baobuibk/NANORACK_EXP_V101_HW/MEETING NOTE.docx

MEETING NOTE

OBC

Board OBC thêm chức năng OTA qua USB hoặc storage, update firmware cho chính OBC và những bo khác

USB5533 (USB3.0)

EXP

Sử dụng connector có chốt gài

Giảm bỏ effuse

Chủ động điều khiển laser, photo (OBC chỉ điều khiển EXP ko điều khiển laser, photo)

4 TEC

4 heater

2 i2c sensor

1 ir led

1 camera

1 usb

LASER

Thiếu test point

PHOTO

Photo diode đang sai chiều

Thiếu test point
