baobuibk/NANORACK_EXP_V101_HW/BOM/EXP_V101_BOM.xlsx

Name/Comment | Description | Designator | Footprint | Manufacturer | Manufacturer P/N | Quantity | STATUS | Order from | PLACE | Những thay đổi ngày 16/01/2025
BT_NRST | SWITCH TACTILE SPST-NO 0.05A 12V | BT1 |  | C&K | PTS636SK25FSMTRLFS | 1 | ORDERRED | EXP_V100
100uF 10V | CAP TANT 100UF 20% 10V 1206 | C1, C2, C6, C9, C18, C19, C20, C23 | TANTALUM_SMD_1206 | Kyocera AVX | TLJA107M010R1400 | 8 | ORDERRED | EXP_V100
4.7uF 25V | CAP CER 4.7UF 6.3V X7R 0603 | C3, C22, C70, C71, C72, C73, C96, C97, C98, C99, C153 | CN-SMD-0603 | Samsung | CL10B475KQ8NQNC | 11 | ORDERRED | EXP_V100 |  |  | ORDERRED | Đã mua trước đây
2.2nF 25V | CAP CER 2200PF 50V X7R 0603 | C4, C5, C7, C8 | CN-SMD-0603 | Samsung | CL10B222KB8NNNC | 4 | ORDERRED | EXP_V100 |  |  | NEW | Chưa mua trước đây
0.22uF 25V | CAP CER 0.22UF 25V X7R 0603 | C10, C11, C12, C13, C15, C16, C17, C21, C25, C32, C33, C34, C35, C36, C37, C38, C39, C40, C41, C42, C43, C44, C45, C46, C47, C48, C49, C50, C51, C52, C53, C54, C55, C56, C57, C58, C59, C60, C61, C62, C63, C64, C65, C66, C67, C68, C69, C76, C77, C78, C79, C92, C94, C102, C103, C104, C105, C118, C119, C122, C123, C124, C125, C126, C127, C128, C129, C130, C131, C132, C133, C134, C135, C140, C141, C144, C145, C147, C151, C152, C155, C156, C157, C158 | CN-SMD-0603 | Samsung | CL10B224KO8NNNC | 84 | ORDERRED | EXP_V100 |  | Thay đổi số lượng (87->84) | DNP | Do Not Place
0.01uF 25V | CAP CER 10000PF 50V X7R 0603 | C14 | CN-SMD-0603 | Samsung | CL10B103KB8NNNC | 1 | ORDERRED | PDU
0.1uF 25V | CAP CER 0.1UF 25V X7R 0603 | C24, C74, C75, C80, C81, C82, C83, C100, C101, C106, C107, C108, C109, C154 | CN-SMD-0603 | Samsung | CL10B104KA8NNNC | 14 | ORDERRED | EXP_V100
470nF 25V | CAP CER 0.47UF 16V X7R 0603 | C26 | CN-SMD-0603 | Samsung | CL10B474KO8NNNC | 1 | ORDERRED | EXP_V100
1uF 25V | CAP CER 1UF 25V X7R 0603 | C29, C30, C84, C85, C90, C91, C110, C111, C116, C117, C136, C137, C138, C139, C142, C143, C149, C150 | CN-SMD-0603 | Samsung | CL10B105KA8NNNC | 18 | ORDERRED | EXP_V100
47nF 25V | CAP CER 0.047UF 16V X7R 0603 | C86, C87, C88, C89, C93, C95, C112, C113, C114, C115, C120, C121 | CN-SMD-0603 | Samsung | CL10B473KO8NNNC | 12 | ORDERRED | EXP_V100
12pF 25V | CAP CER 12PF 50V C0G/NP0 0603 | C146, C148 | CN-SMD-0603 | TDK | C0603CH1E120K030BA | 2 | ORDERRED | EXP_V100
SS54 | DIODE SCHOTTKY 40V 5A SMA | D1, D2, D3 | DO214-AC-SMA | EVVO | SS54 | 3 | ORDERRED | EXP_V100
DSS14U | DIODE SCHOTTKY 40V 1A SOD123FL | D4 | SOD-123 | SMC | DSS14UTR | 1 | ORDERRED | EXP_V100
1N4148W-TP | DIODE GEN PURP 100V 300MA SOD123 | D6 | SOD-123 | MCC | 1N4148W-TP | 1 | ORDERRED | EXP_V100
YELLOW | LED YELLOW CLEAR 0603 SMD | DS1 | LED_0603_RED | Wurth Electronics | 150060YS75000 | 1 | ORDERRED | EXP_V100
RED | LED RED CLEAR 0603 SMD | DS2, DS3, DS4 | LED_0603_RED | Wurth Electronics | 150060RS75000 | 3 | ORDERRED | EXP_V100
GREEN | LED GREEN CLEAR 0603 SMD | DS5 | LED_0603_RED | Wurth Electronics | 150060GS75000 | 1 | ORDERRED | EXP_V100
BLUE | LED BLUE CLEAR 0603 SMD | DS6 | LED_0603_RED | Wurth Electronics | 150060BS75000 | 1 | ORDERRED | EXP_V100
JP5 | WR-PHD 2.54 mm Angled Socket Header | J1 |  |  |  | 1 |  |  | DNP
532610271 | CONN HEADER SMD R/A 2POS 1.25MM | J2 | 0532610271 | Molex | 0532610271 | 1 | NEW
~~532610871~~ | ~~CONN HEADER SMD R/A 8POS 1.25MM~~ |  | ~~0532610871~~ | ~~Molex~~ | ~~0532610871~~ | ~~1~~ | NEW |  |  | Không dùng trên V101 nữa
M80-6661642 | CONN HEADER SMD R/A 16POS 2MM | J3, J7 | m80-6661642 | Harwin | M80-6661642 | 2 | ORDERRED | EXP_V100 |  | Thay đổi số lượng (1->2)
M80-8283442 | CONN HEADER SMD 34POS 2MM | J4 | M80-8283442 | Harwin | M80-8283442 | 1 | ORDERRED | EXP_V100 |  | Thay đổi số lượng (2->1)
ESQ-107-48-G-D | CONN SOCKET 14POS 0.1 GOLD PCB | J5 | ESQ-107-48-G-D | Samtec | ESQ-107-48-G-D | 1 | NEW
532610971 | CONN HEADER SMD R/A 9POS 1.25MM | J6 | 532610971 | Molex | 0532610971 | 1 | NEW
BM04B-SRSS-TB | CONN HEADER SMD 4POS 1MM | J8, J9 | BM04B-SRSS-TB | JST | BM04B-SRSS-TBT(LF)(SN) | 2 | ORDERRED | EXP_V100
JP3 | WR-PHD 2.54 mm Angled Socket Header | J10 |  |  |  | 1 |  |  | DNP | Thay đổi từ "530470310" thành JP3 (2.54mm)
jumper2 |  | JP1, JP2 |  |  |  | 2 |  |  | DNP | Thêm component jumper, không linh kiện
22 μH | FIXED IND 22UH 2.5A 170 MOHM SMD | L1 | PSM6050 | Bourns | SRP7050TA-220M | 1 | ORDERRED | PDU
82uH | SRR4828A-820M | L2 | L-SMD-M-4.8x4.8x2.8mm | Bourns | SRR4828A-820M | 1 | ODERED | EXP_V100
1uH | FIXED IND 1UH 4A 38 MOHM SMD | L5, L6, L7, L8 | L-SMD-M-3.5x3.5x2mm | Bourns | SRP3020TA-1R0M | 4 | ODERED | EXP_V100
10uH/250mA | FIXED IND 10UH 300MA 600MOHM SMD | L9 | L-SMD-0603 | TDK | MLZ1608N100LT000 | 1 | ODERED | EXP_V100
AO3400A | MOSFET N-CH 30V 5.7A SOT23-3L | Q1, Q2, Q3, Q4 | SOT23-13_2 | Alpha & Omega Semiconductor | AO3400A | 4 | ODERED | EXP_V100
120R 1% | RES SMD 120 OHM 1% 1/10W 0603 | R1, R3, R59, R60, R95, R97, R99, R101 | RES-SMD-0603 | Panasonic | ERJ-3EKF1200V | 8 | ODERED | EXP_V100
10k 1% | RES SMD 10K OHM 1% 1/10W 0603 | R2, R4, R5, R6, R23, R24, R37, R41, R42, R45, R46, R51, R52, R79, R80, R81, R82, R89, R90, R91, R92, R96, R98, R100, R102, R109, R113, R122, R123, R124, R125, R126, R127, R128, R129, R132, R133 | RES-SMD-0603 | Panasonic | ERJ-3EKF1002V | 37 | ODERED | EXP_V100
470k 1% | RES SMD 470K OHM 1% 1/10W 0603 | R7, R9 | RES-SMD-0603 | Panasonic | ERJ-3EKF4703V | 2 | ODERED | EXP_V100
130k 1% | RES SMD 130K OHM 1% 1/10W 0603 | R8, R10 | RES-SMD-0603 | Panasonic | ERJ-3EKF1303V | 2 | ODERED | EXP_V100
3.24k 1% | RES SMD 3.24K OHM 1% 1/10W 0603 | R11 | RES-SMD-0603 | Panasonic | ERJ-3EKF3241V | 1 | ODERED | PDU
22R 1% | RES SMD 22 OHM 1% 1/10W 0603 | R12, R14, R15, R16, R17, R18, R19, R22, R25, R26, R27, R28, R32, R34, R35, R38, R39, R40, R49, R50, R55, R56, R62, R63, R66, R67, R69, R70, R72, R74, R75, R76, R77, R78, R83, R85, R86, R87, R88, R103, R104, R105, R106, R107, R114, R115, R116, R118, R119, R120, R121, R130, R131, R136, R137 | RES-SMD-0603 | Panasonic | ERJ-3EKF22R0V | 55 | ODERED | EXP_V100 |  | Thay đổi số lượng (58->55)
2k2 1% | RES SMD 2K2 OHM 1% 1/10W 0603 | R13, R29, R30, R31, R112, R117 | RES-SMD-0603 | Panasonic | ERJ-3EKF2201V | 6 | ODERED | EXP_V100
1k 1% | RES SMD 1K OHM 1% 1/10W 0603 | R20, R21, R33 | RES-SMD-0603 | Panasonic | ERJ-3EKF1001V | 3 | ODERED | EXP_V100
0R2 | RES SMD 0.2 OHM 1% 1W 1206 | R36 | RES-SMD-1206 | Yageo | PE1206FRF470R2L | 1 | ODERED | EXP_V100
100k 1% | RES SMD 100K OHM 1% 1/10W 0603 | R43, R44, R47, R48, R53, R54, R134, R135 | RES-SMD-0603 | Panasonic | ERJ-3EKF1003V | 8 | ODERED | EXP_V100
4.7k 1% | RES SMD 4.7K OHM 1% 1/10W 0603 | R57, R58, R61, R64, R65, R68, R71, R73, R84, R138 | RES-SMD-0603 | Panasonic | ERJ-3EKF4701V | 10 | ODERED | EXP_V100 |  | Thay đổi số lượng (8->10)
1k 1% / DNP | RES SMD 1K OHM 1% 1/10W 0603 | R108 | RES-SMD-0603 | Panasonic | ERJ-3EKF1001V | 1 | ODERED | EXP_V100 | DNP
16.5k1% | RES SMD 16K5 OHM 1% 1/10W 0603 | R110 | RES-SMD-0603 | Panasonic | ERJ-3EKF1652V | 1 | ODERED | EXP_V100
19.1k 1% | RES SMD 19K1 OHM 1% 1/10W 0603 | R111 | RES-SMD-0603 | Panasonic | ERJ-3EKF1912V | 1 | ODERED | EXP_V100
TVS2200DRVR | UNIDIR PRECISION SURGE DIODE | TVS1, TVS2 | TVS2200 | Texas Instruments | TVS2200DRVR | 2 | ODERED | EXP_V100
S2305 | TVS DIODE 5VWM 10.8VC SOT23 | TVS4, TVS8, TVS10, TVS15, TVS16 | sot23-12_3 | SMC Diode Solutions | S2305 | 5 | ODERED | EXP_V100 |  | Thay đổi số lượng (6->5)
TPS259470ARPWR | IC ELECTRONIC FUSE 10VQFN | U1, U2 | VQFN-HR-10 | Texas Instruments | TPS259470ARPWR | 2 | ODERED | EXP_V100
TPS5430DDAR | IC REG BUCK ADJ 3A 8SOPWR | U3 | TPS5430DDAR | Texas Instruments | TPS5430DDAR | 1 | ODERED | PDU
TPS7A4533DCQR | IC REG LINEAR 3.3V 1.5A SOT223-6 | U4 | SOT223_6 | Texas Instruments | TPS7A4533DCQR | 1 | ODERED | EXP_V100
AL8843SP-13 | IC LED DRIVER RGLTR PWM 3A 8SO | U5 | SO8_EPAD | Diodes | AL8843SP-13 | 1 | ODERED | EXP_V100
OPA2340UA | IC CMOS 2 CIRCUIT 8SOIC | U6, U7, U9, U10 | SO8 | Texas Instruments | OPA2340UA | 4 | ODERED | EXP_V100
ADG1414BCPZ-REEL7 | IC SW SPST-NOX8 11.5OHM 24LFCSP | U8 | ADG1414 | Analog Devices Inc. | ADG1414BCPZ-REEL7 | 1 | NEW |  |  | Thêm part mới cho V101
ADUM1250WSRZ | DGTL ISOL 2500VRMS 2CH I2C 8SOIC | U11 | SOIC-8 | Analog Devices | ADUM1250WSRZ | 1 | ODERED | EXP_V100
ISO1432DW | IC TRANSCEIVER FULL 1/1 16SOIC | U12 | ISO1432DW | Texas Instruments | ISO1432DW | 1 | ODERED | EXP_V100
ISO1042BQDWVRQ1 | IC TRANSCEIVER FULL 1/1 8SOIC | U13 | ISO1042 | Texas Instruments | ISO1042BQDWVRQ1 | 1 | ODERED | EXP_V100
LT8722AV#PBF | IC GATE DRVR FULL-BRIDGE 18QFN | U14, U15, U16, U17 | QFN18 | Analog Devices | LT8722AV#PBF | 4 | ODERED | EXP_V100
STM32F407VGT7 | ARM® Cortex®-M4 STM32F4 Microcontroller IC 32-Bit Single-Core 168MHz 1MB (1M x 8) FLASH 100-LQFP (14x14) | U18 | LQFP-100 | STMicroelectronics | STM32F407VGT7 | 1 | ODERED | EXP_V100
TPL5010DDCR | IC OSC PROG TIMER TSOT23-6 | U19 | SOT23-6-123_456 | Texas Instruments | TPL5010DDCR | 1 | ODERED | EXP_V100
PCA9508DP,118 | IC REDRIVER I2C HOTSWAP 8TSSOP | U20, U21 | TSOP8 | NXP Semiconductors | PCA9508DP,118 | 2 | ODERED | EXP_V100
8MHz | Crystal, 8 MHz, -30 to 85 degC, 3.2 x 2.5 x 0.9 mm SMD | X1 | XT4-16.000MHz-4_V | ECS International | ECS-80-8-33Q-ADS | 1 | ODERED | EXP_V100
510210200 | CONN RCPT HSG 2POS 1.25MM | Mating with J2 |  | Molex | 0510210200 | 1 | NEW |  | Wire for connector
~~510210800~~ | ~~CONN RCPT HSG 8POS 1.25MM~~ | ~~Mating with ~~ |  | ~~Molex~~ | ~~0510210800~~ | ~~1~~ | ~~NEW~~ |  | ~~Wire for connector~~ | Không dùng cho V101 nữa
M80-8881605 | CONN RCPT 8POS CRIMP 24-28AWG | Mating with J3, J7 |  | Harwin Inc. | M80-8880805 | 1 | ORDERRED | EXP_V100 | Wire for connector
M80-8883405 | CONN RCPT 34POS CRIMP 24-28AWG | Mating with J4 |  | Harwin Inc. | M80-8883405 | 1 | ORDERRED | EXP_V100 | Wire for connector
510210900 | CONN RCPT HSG 9POS 1.25MM | Mating with J6 |  | Molex | 0510210900 | 1 | NEW |  | Wire for connector
A04SR04SR30K152B | JUMPER 04SR-3S - 04SR-3S 6" | Mating with J8, J9 |  | JST Sales America Inc. | A04SR04SR30K152B | 2 | ORDERRED | EXP_V100 | Wire for connector
~~0510210300~~ | ~~CONN RCPT HSG 3POS 1.25MM~~ | ~~Mating with J10~~ |  | ~~Molex~~ | ~~0510210300~~ | ~~1~~ | ~~NEW~~ |  | ~~Wire for connector~~ | Không dùng cho V101 nữa
