baobuibk/NANORACK_EXP_V101_HW/SCHEMATIC/EXP_V101_SCHE.pdf

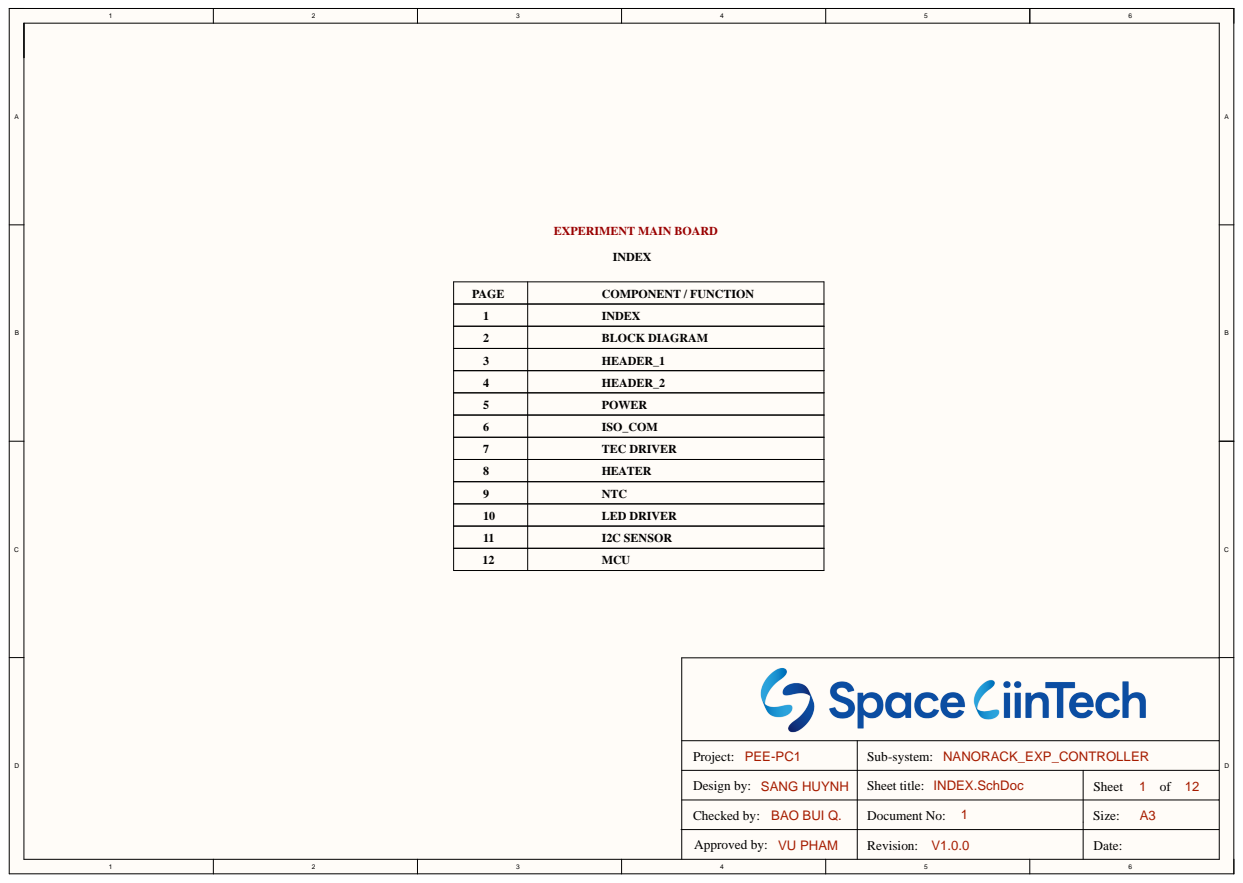
[picture p1: page 1]

PAGE | COMPONENT / FUNCTION

1 INDEX

2 | BLOCK DIAGRAM

3 | HEADER_1

4 | HEADER_2

5 | POWER

6 | ISO_COM

7 | TEC DRIVER

8 | HEATER

9 | NTC

10 | LED DRIVER

11 | I2C SENSOR

12 | MCU

Project: PEE-PC1 | Sub-system: NANORACK_EXP_CONTROLLER

Design by: SANG HUYNH | Sheet title: INDEX.SchDoc | Sheet 1 of 12

Checked by: BAO BUI Q. | Document No: 1 | Size: A3

Approved by: VU PHAM | Revision: V1.0.0 | Date:

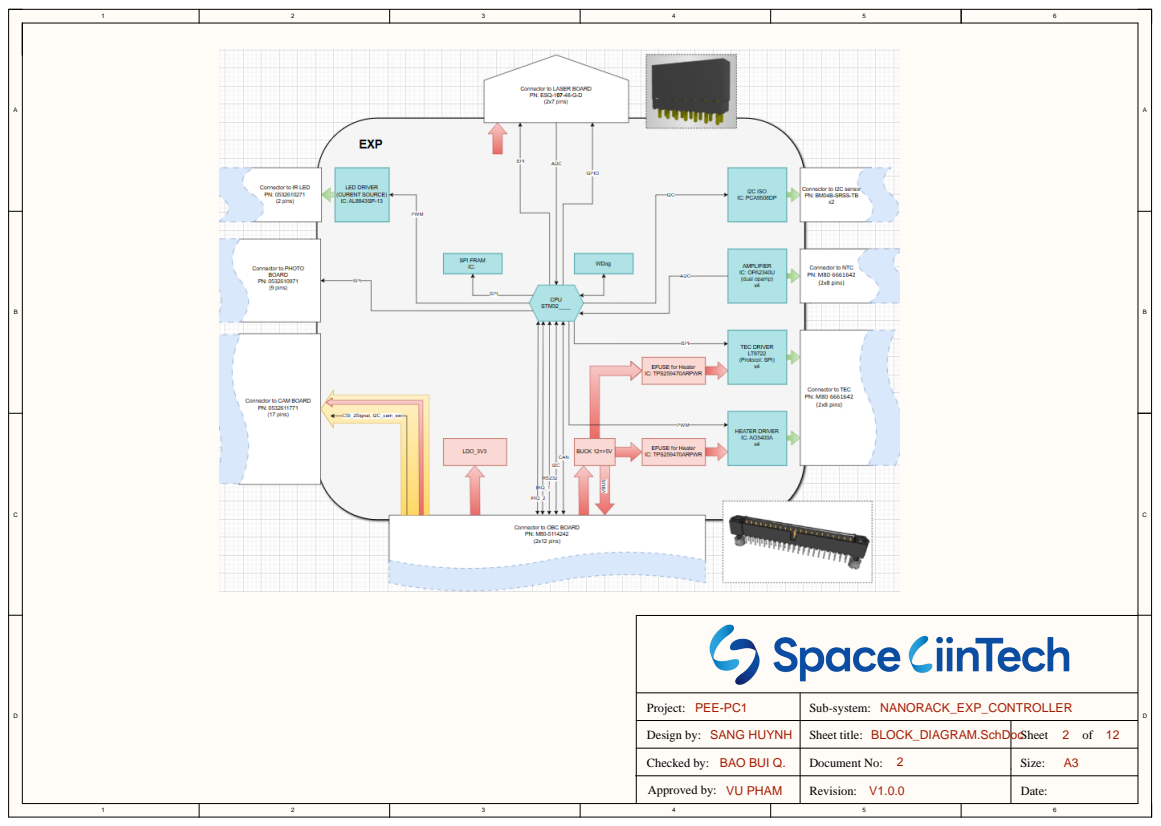
[picture p2: page 2]

Project: PEE-PC1 | Sub-system: NANORACK_EXP_CONTROLLER

Design by: SANG HUYNH | Sheet title: BLOCK_DIAGRAM.SchDoc | Sheet 2 of 12

Checked by: BAO BUI Q. | Document No: 2 | Size: A3

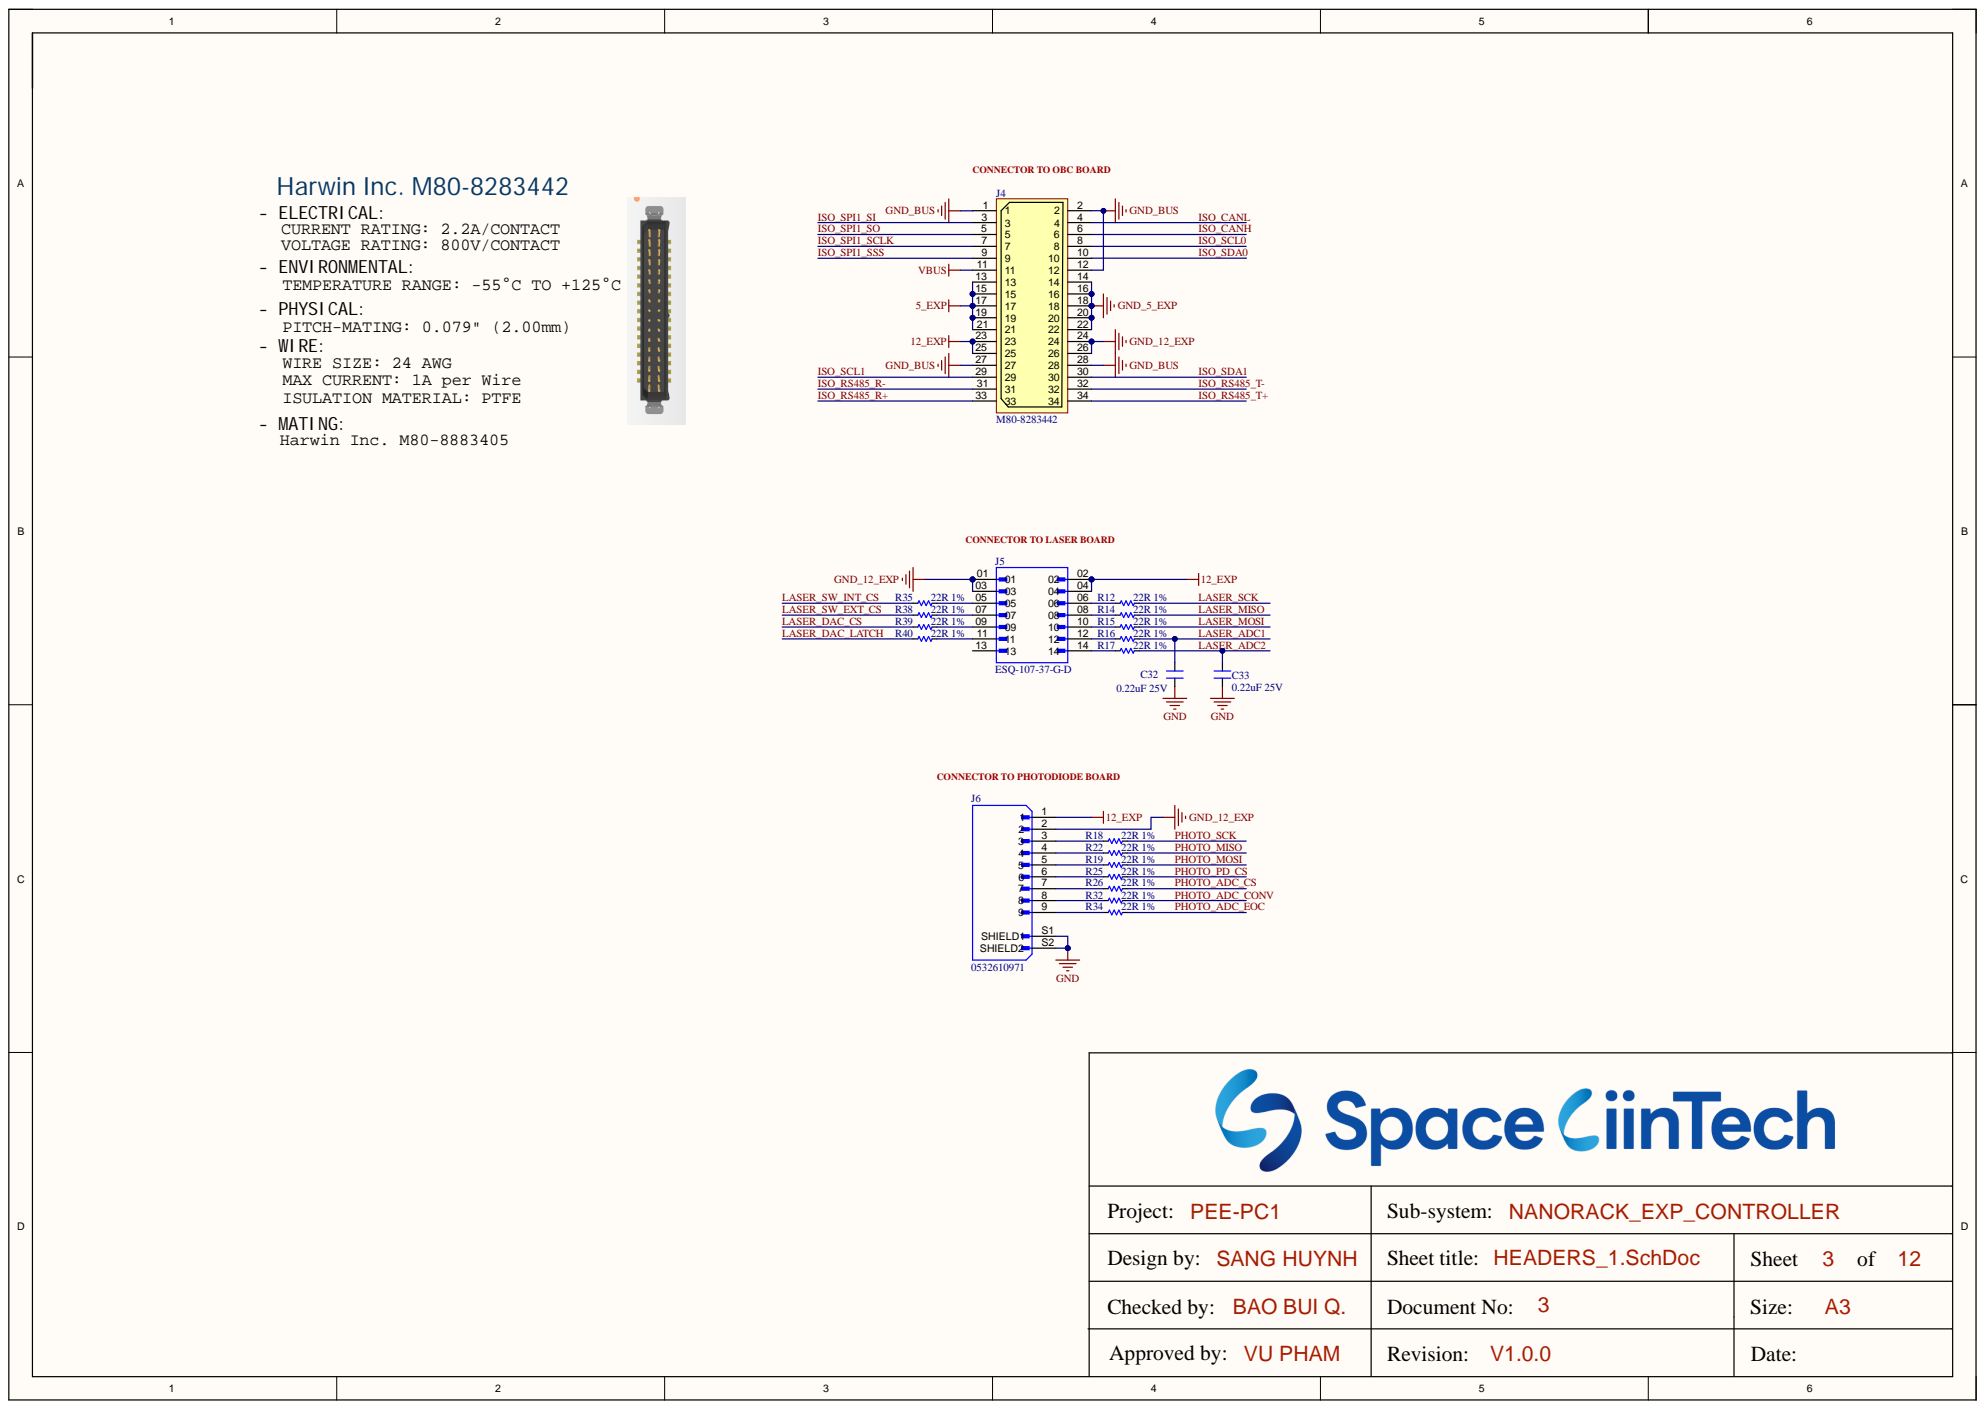
[picture p3: page 3]

CONNECTOR TO OBC BOARD

- ELECTRICAL: CURRENT RATING: 2.2A/CONTACT VOLTAGE RATING: 800V/CONTACT

- ENVIRONMENTAL: TEMPERATURE RANGE: -55°C TO +125°C

- WIRE:
WIRE SIZE: 24 AWG
MAX CURRENT: 1A per Wire
ISULATION MATERIAL: PTFE
- MATING: Harwin Inc. M80-8883405

CONNECTOR TO LASER BOARD

C | GND | C

CONNECTOR TO PHOTODIODE BOARD

Project: PEE-PC1 | Sub-system: NANORACK_EXP_CONTROLLER

Design by: SANG HUYNH | Sheet title: HEADERS_1.SchDoc | Sheet 3 of 12

Checked by: BAO BUI Q. | Document No: 3 | Size: A3

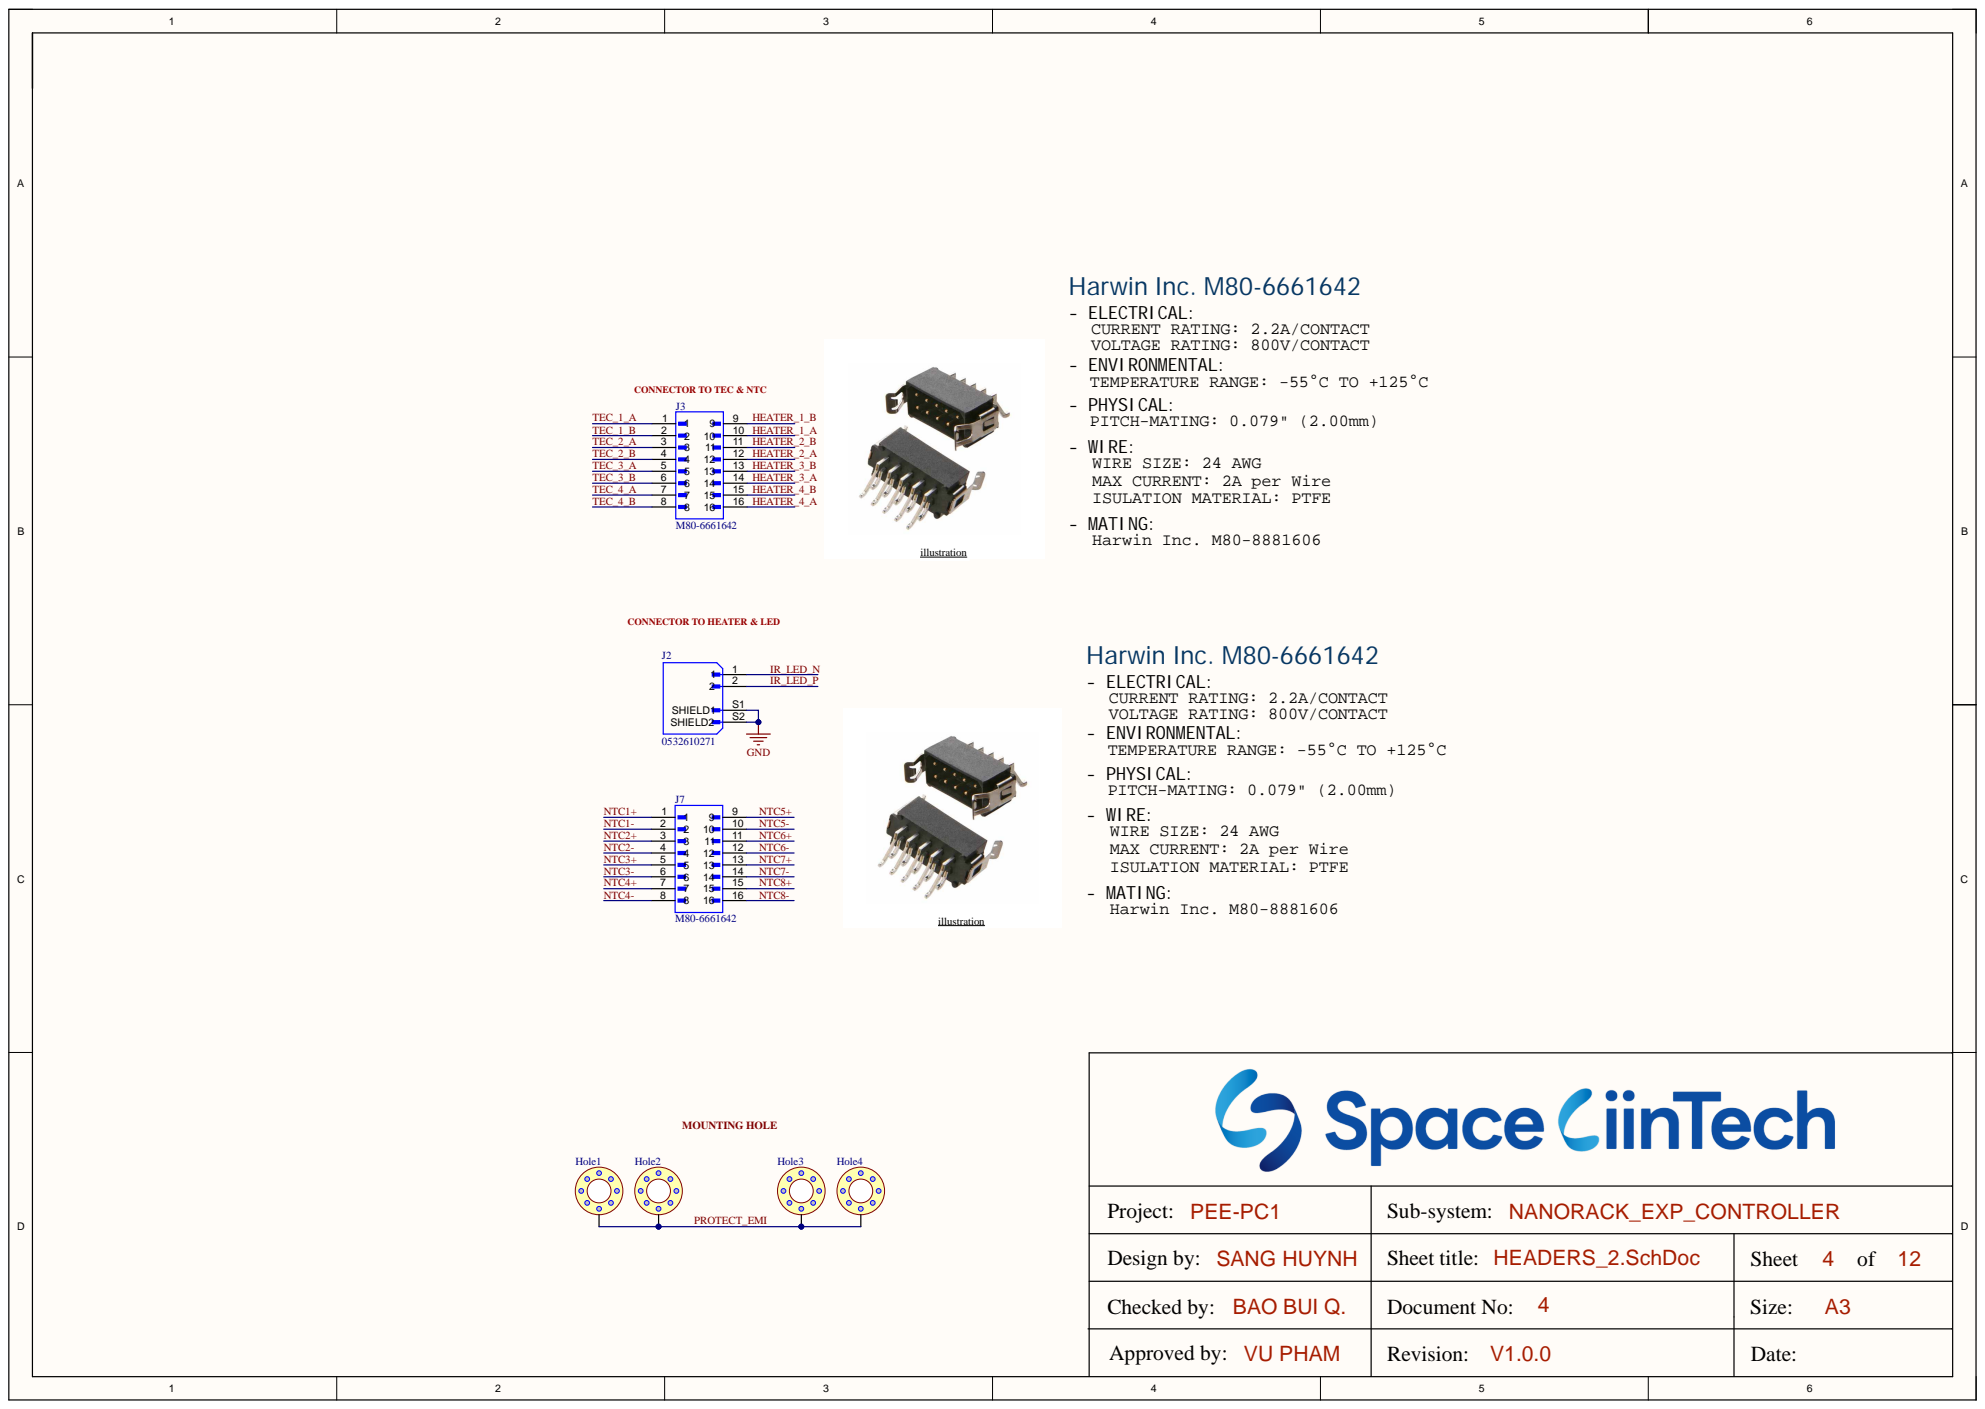
[picture p4: page 4]

- ELECTRICAL: CURRENT RATING: 2.2A/CONTACT VOLTAGE RATING: 800V/CONTACT

- ENVIRONMENTAL: TEMPERATURE RANGE: -55°C TO +125°C

CONNECTOR TO TEC & NTC

- WIRE:
WIRE SIZE: 24 AWG
MAX CURRENT: 2A per Wire
ISULATION MATERIAL: PTFE
- MATING:
Harwin Inc. M80-8881606

CONNECTOR TO HEATER & LED

Project: PEE-PC1 | Sub-system: NANORACK_EXP_CONTROLLER

Design by: SANG HUYNH | Sheet title: HEADERS_2.SchDoc | Sheet 4 of 12

Checked by: BAO BUI Q. | Document No: 4 | Size: A3

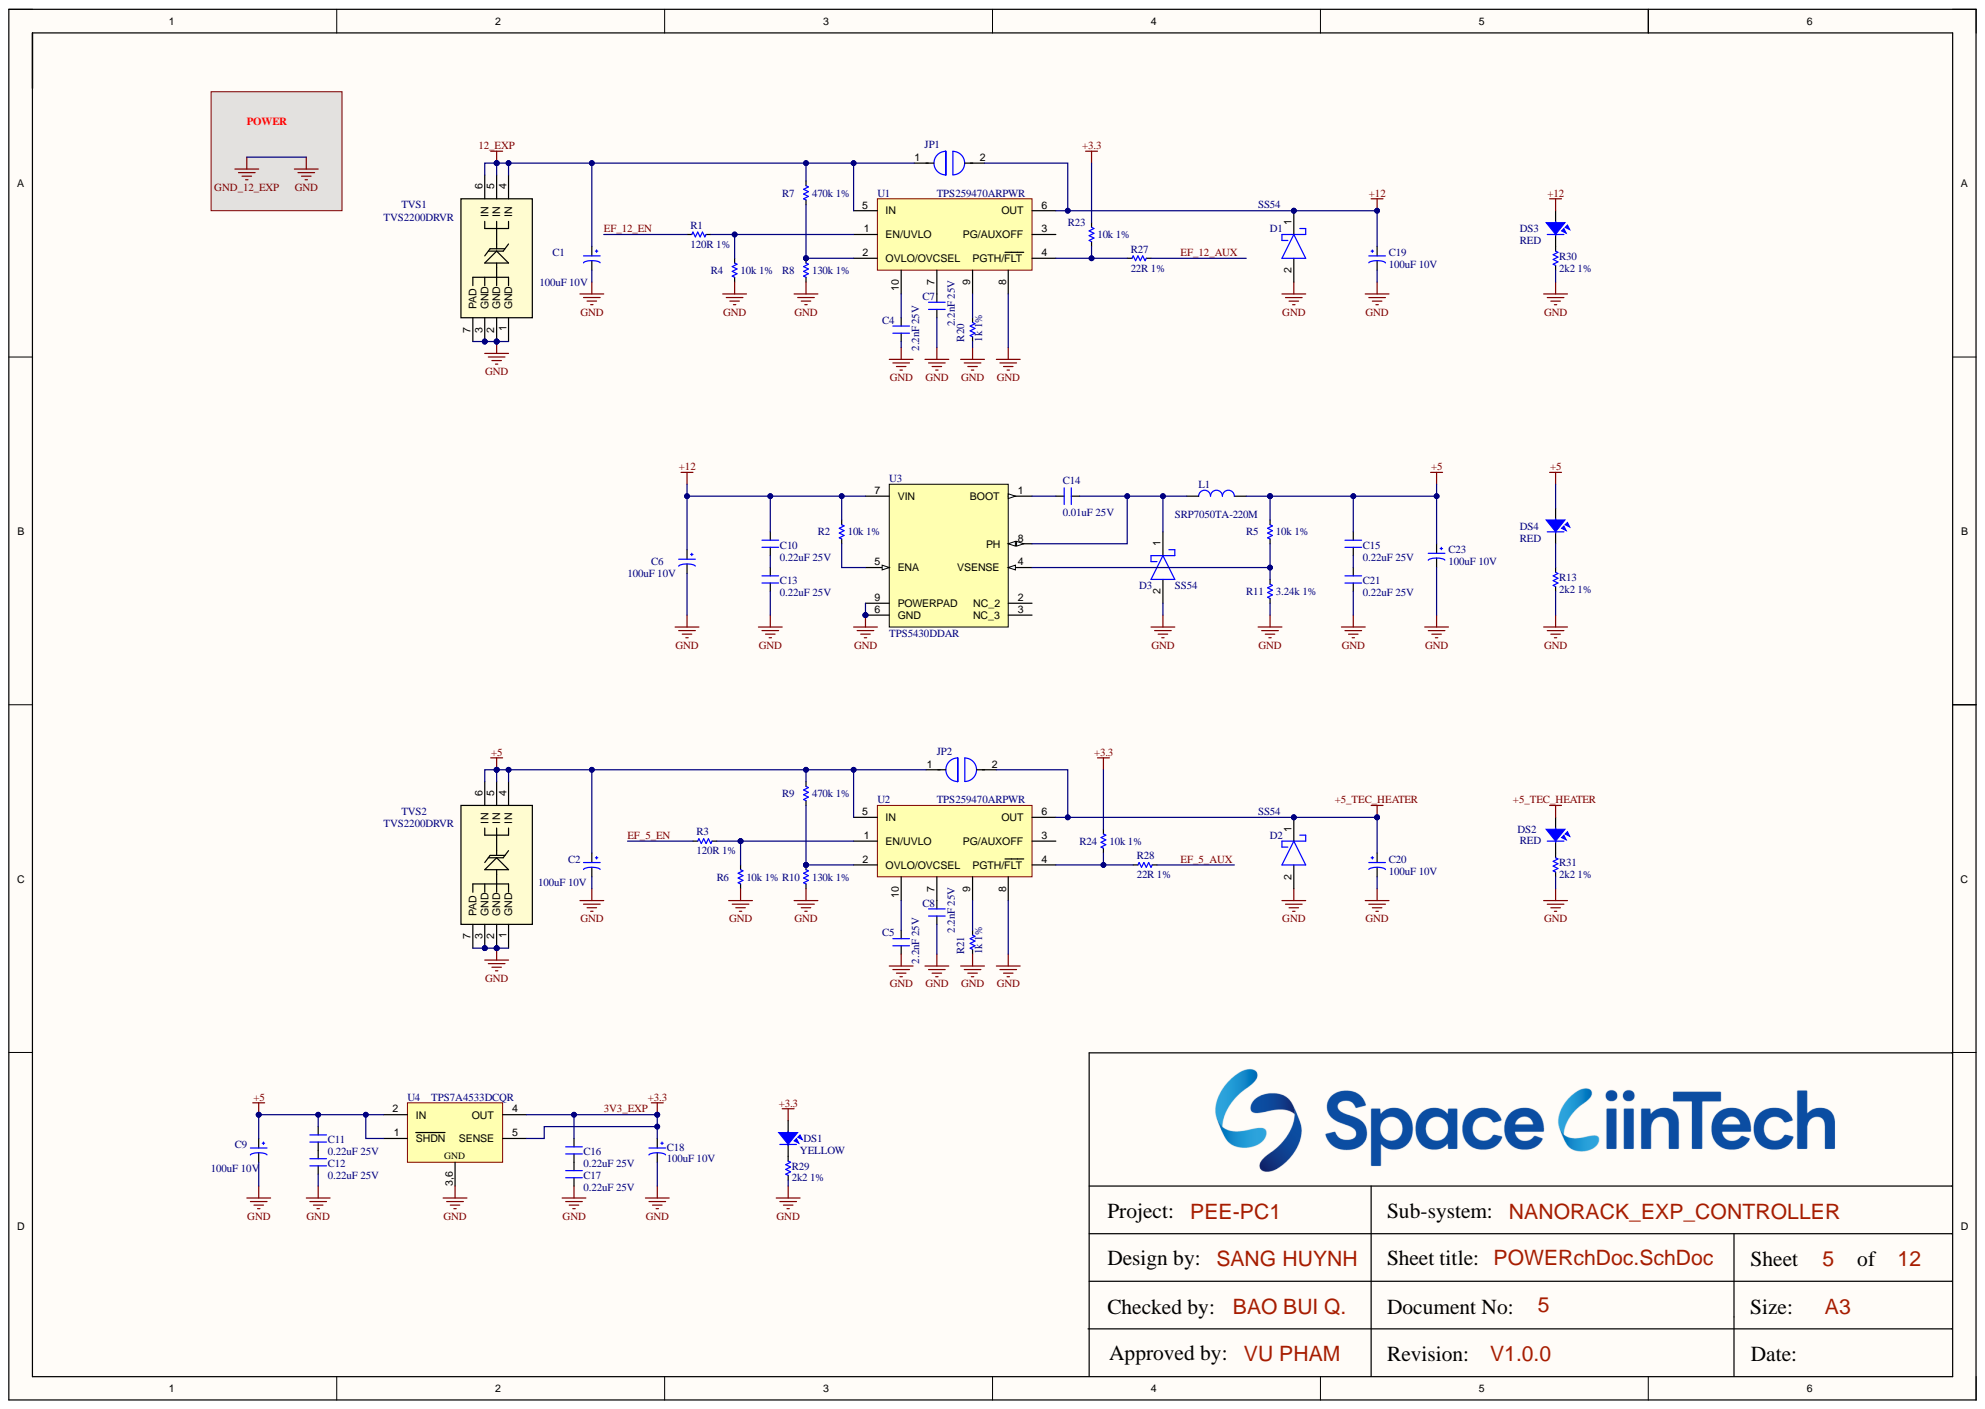
[picture p5: page 5]

IN 4 IN 5 IN 6 PAD 7

Project: PEE-PC1 | Sub-system: NANORACK_EXP_CONTROLLER

Design by: SANG HUYNH | Sheet title: POWERchDoc.SchDoc | Sheet 5 of 12

Checked by: BAO BUI Q. | Document No: 5 | Size: A3

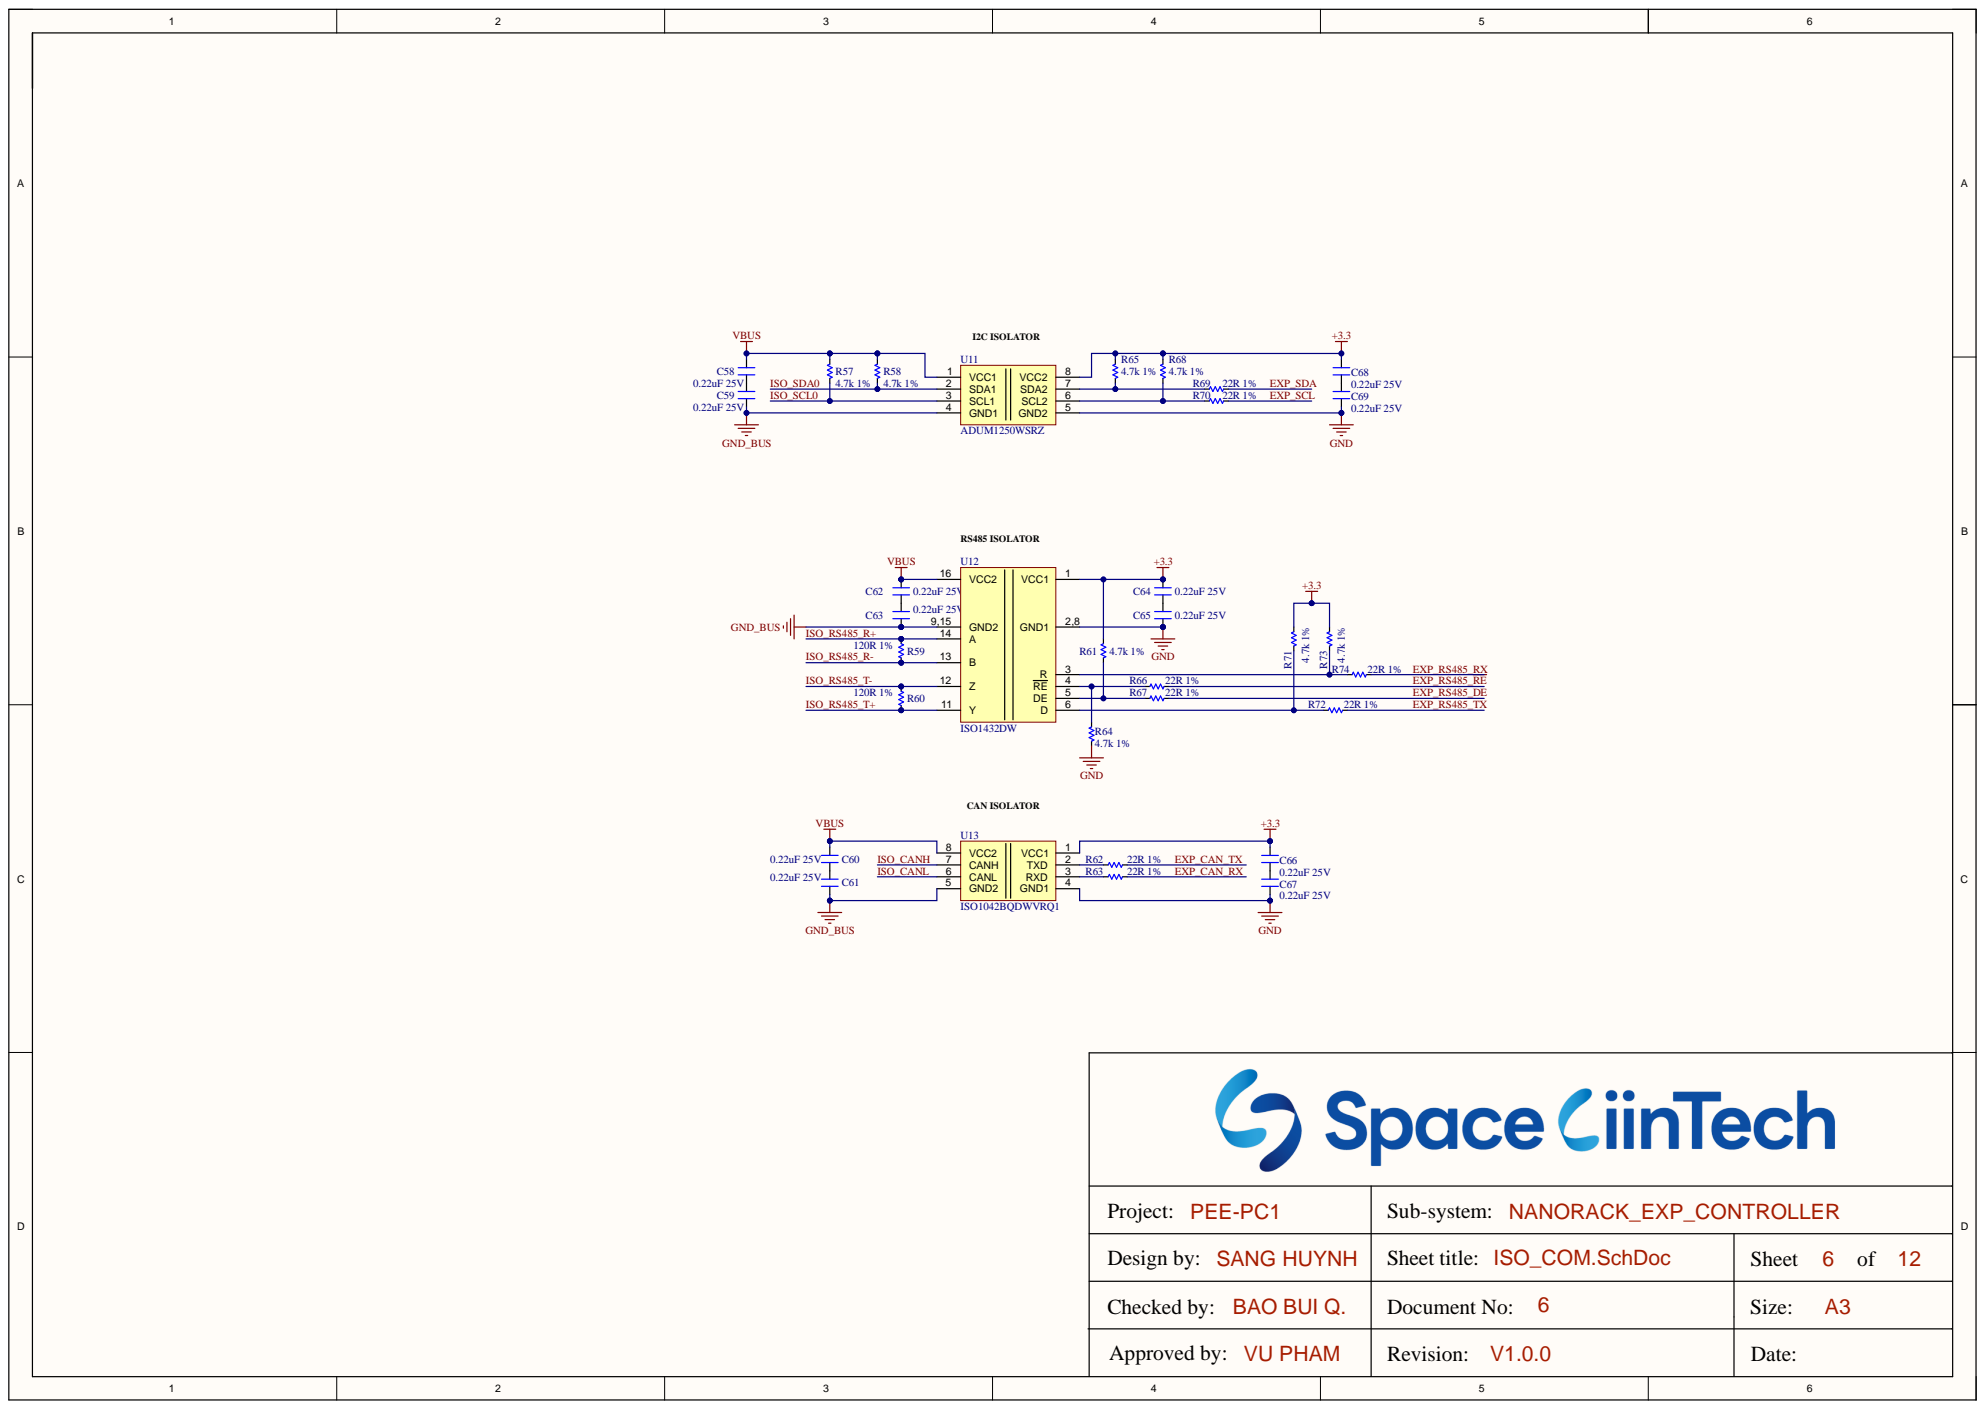
[picture p6: page 6]

Project: PEE-PC1 | Sub-system: NANORACK_EXP_CONTROLLER

Design by: SANG HUYNH | Sheet title: ISO_COM.SchDoc | Sheet 6 of 12

Checked by: BAO BUI Q. | Document No: 6 | Size: A3

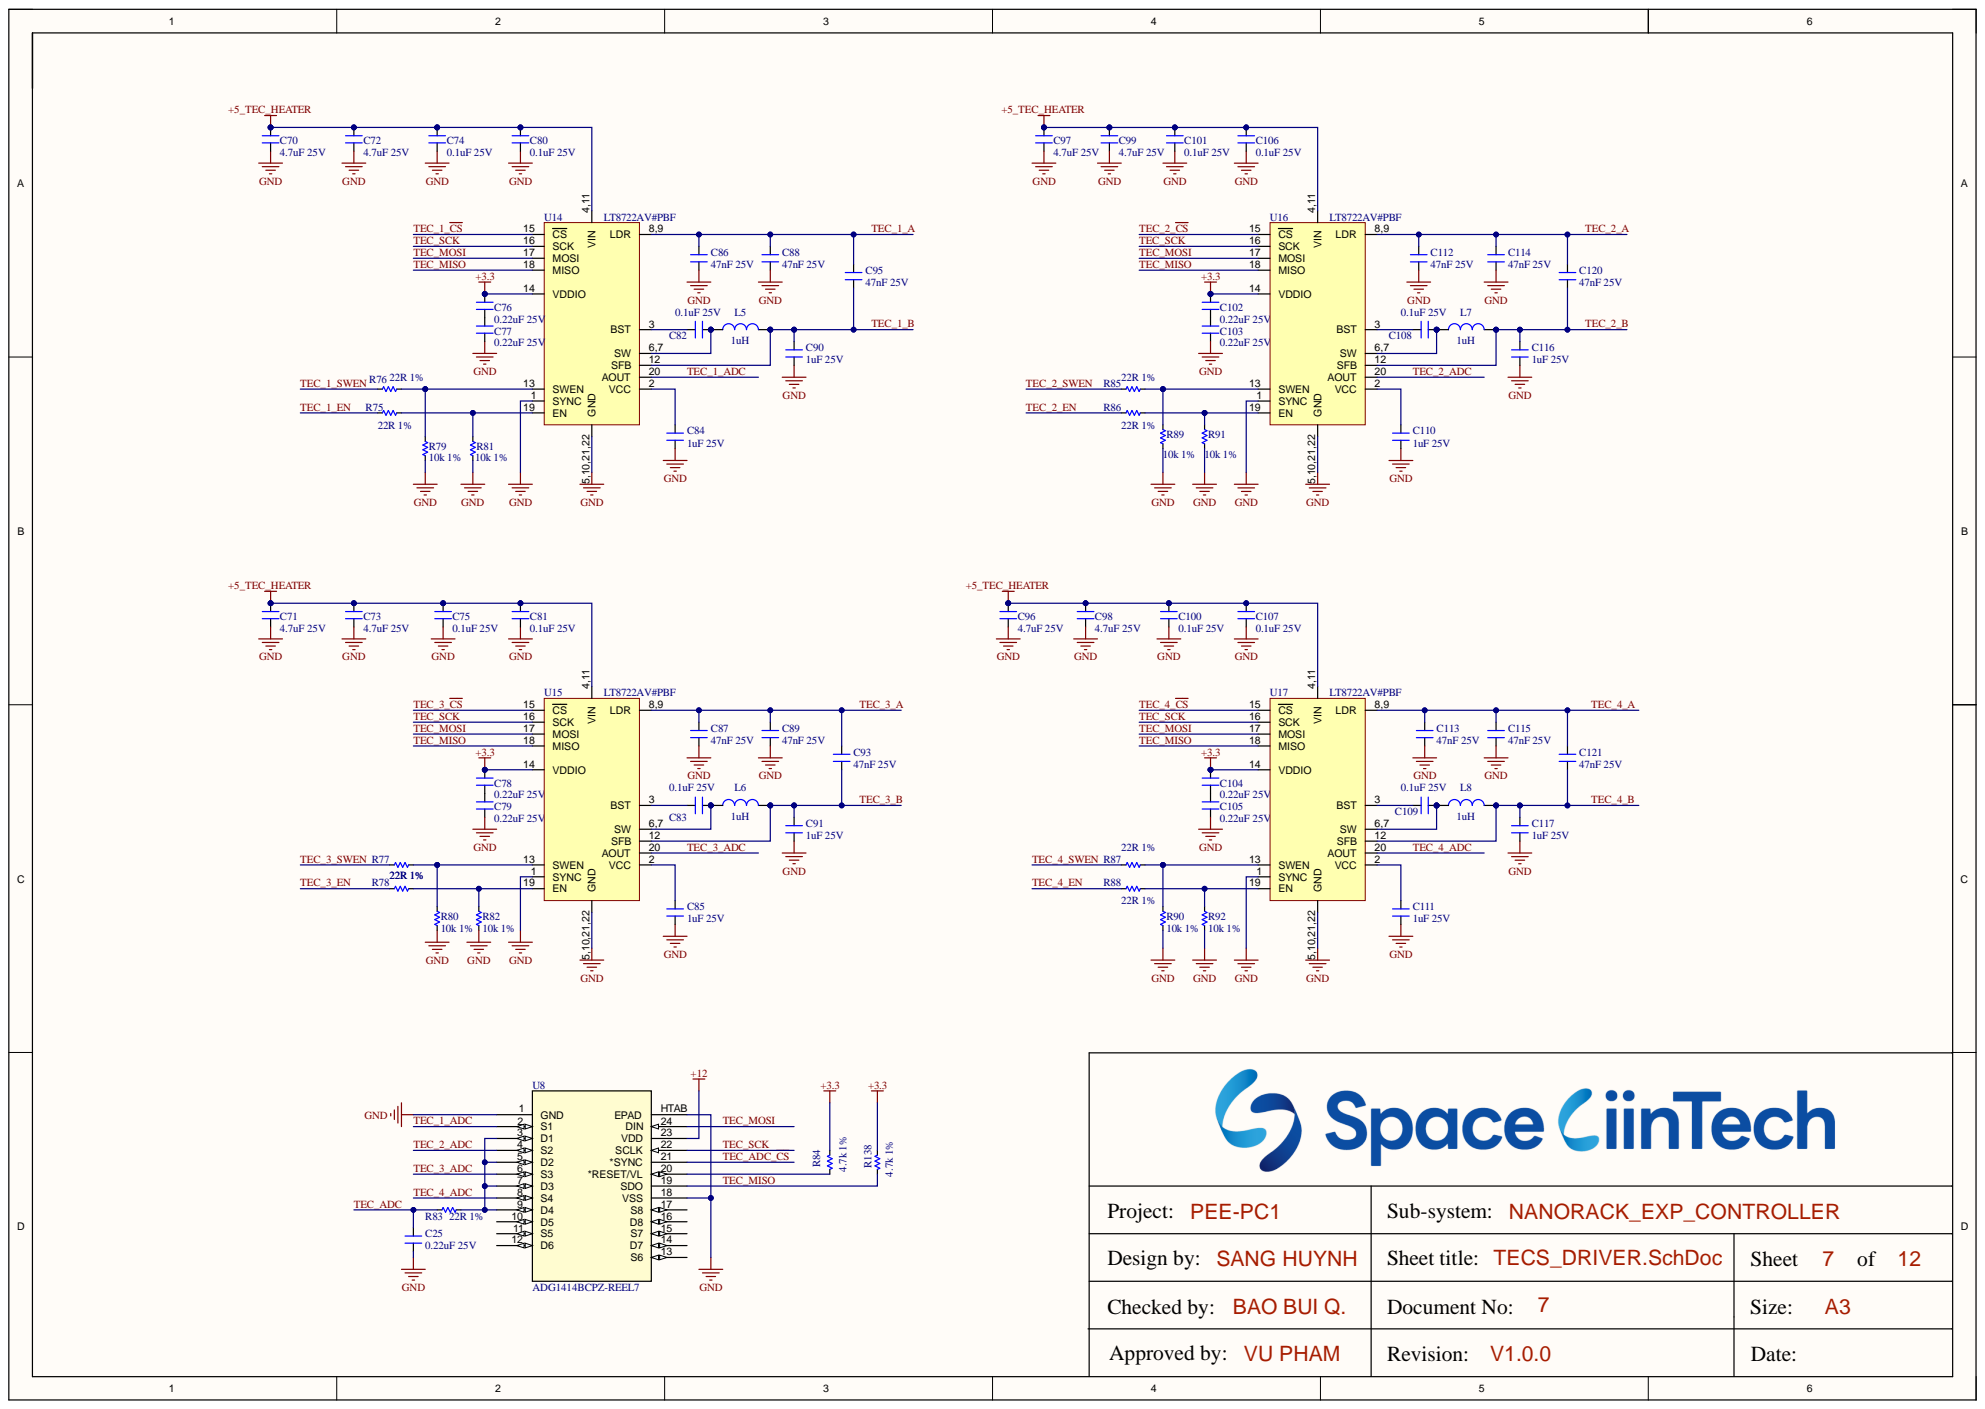
[picture p7: page 7]

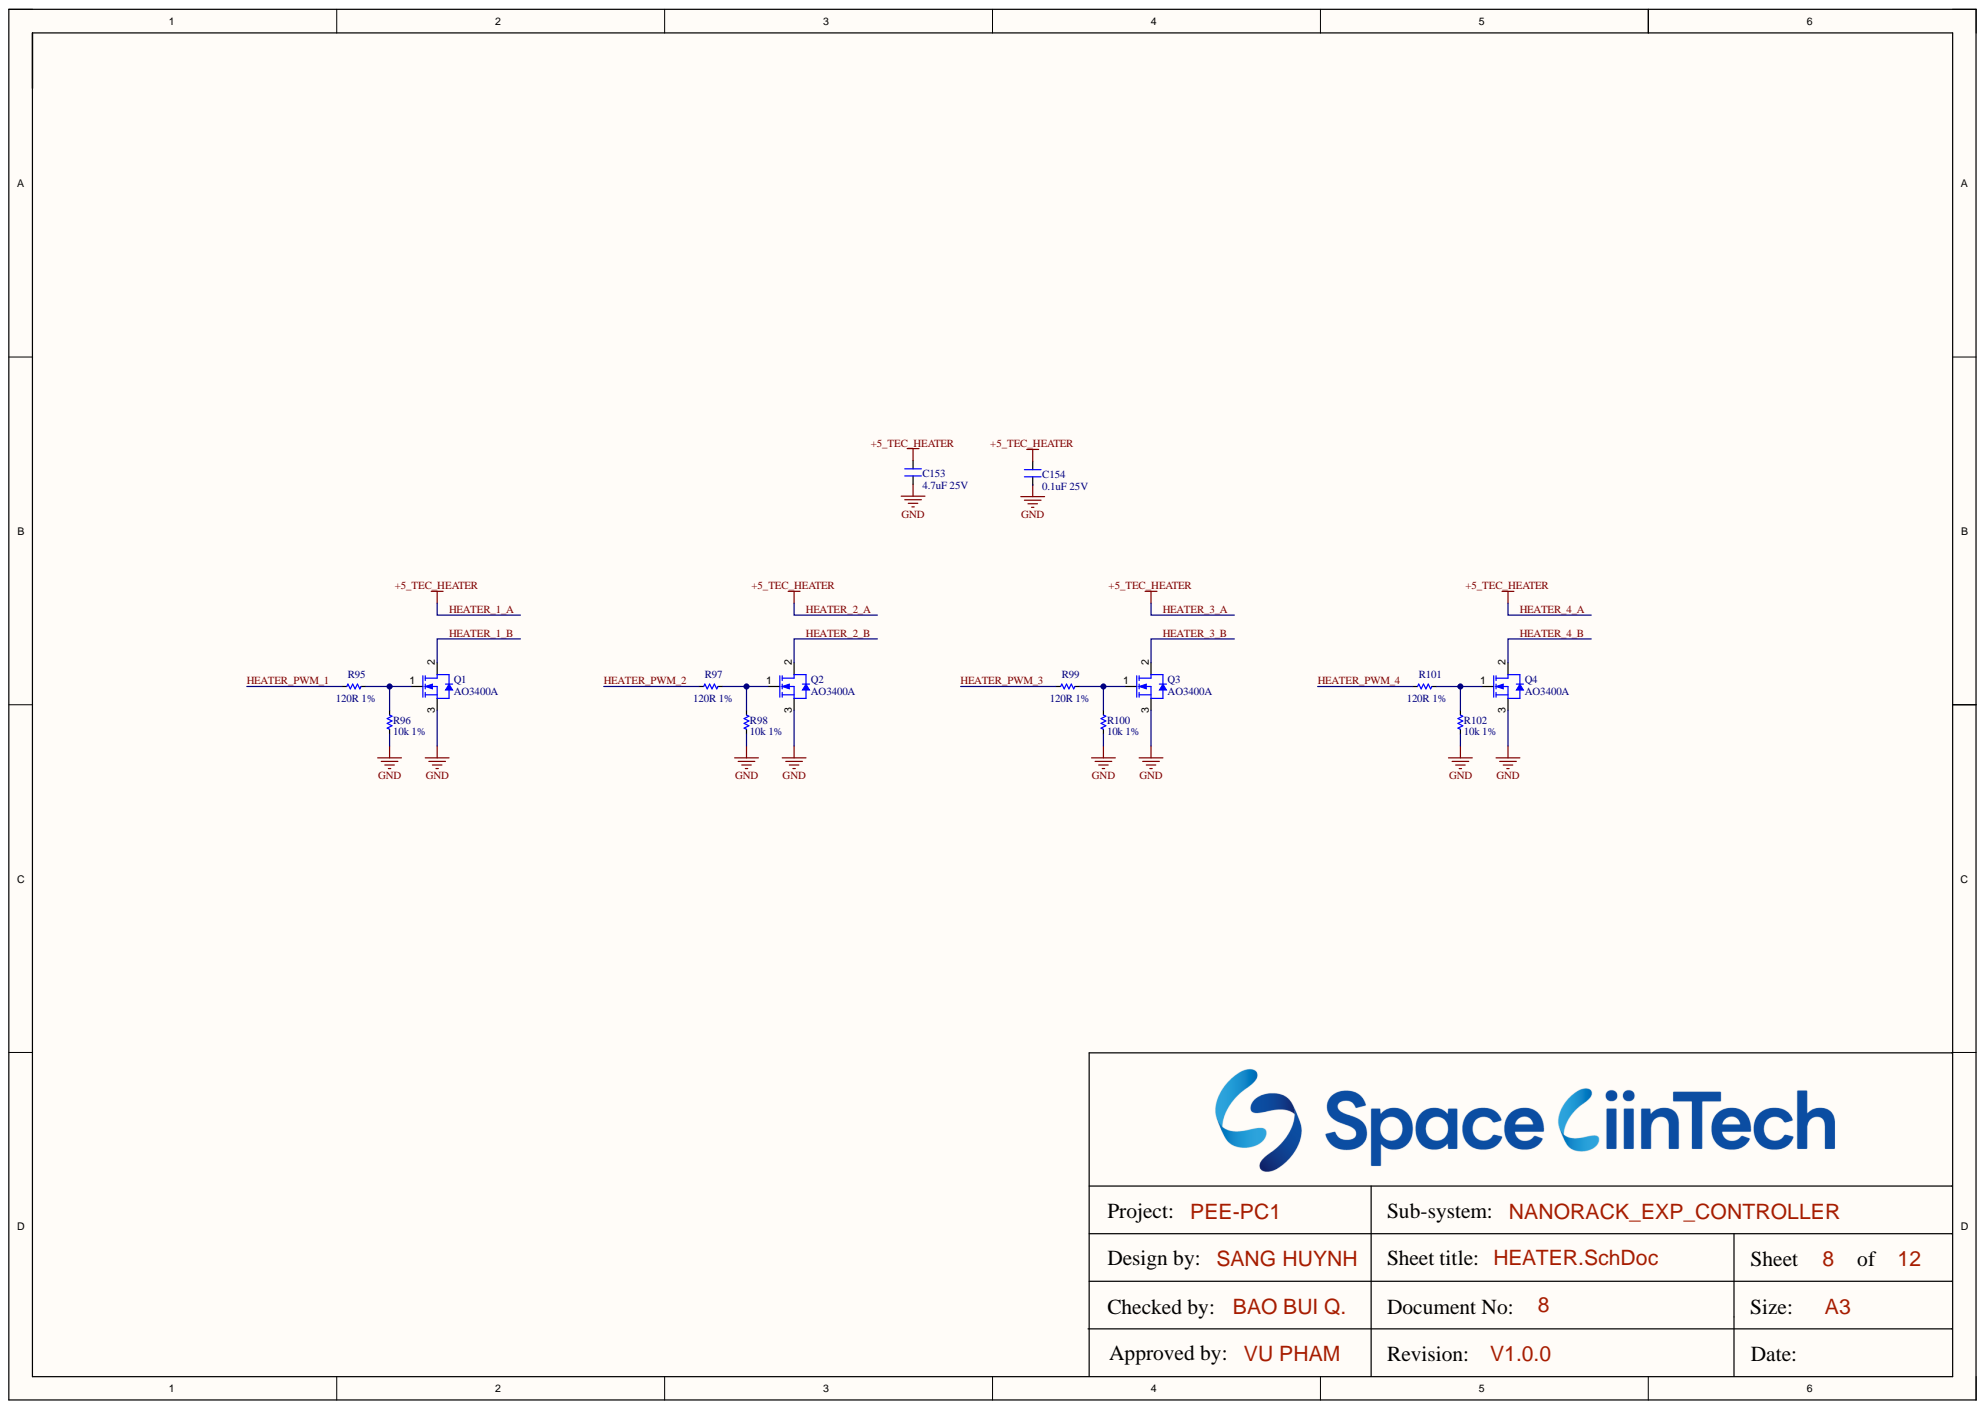
[picture p8: page 8]

Project: PEE-PC1 | Sub-system: NANORACK_EXP_CONTROLLER

Design by: SANG HUYNH | Sheet title: HEATER.SchDoc | Sheet 8 of 12

Checked by: BAO BUI Q. | Document No: 8 | Size: A3

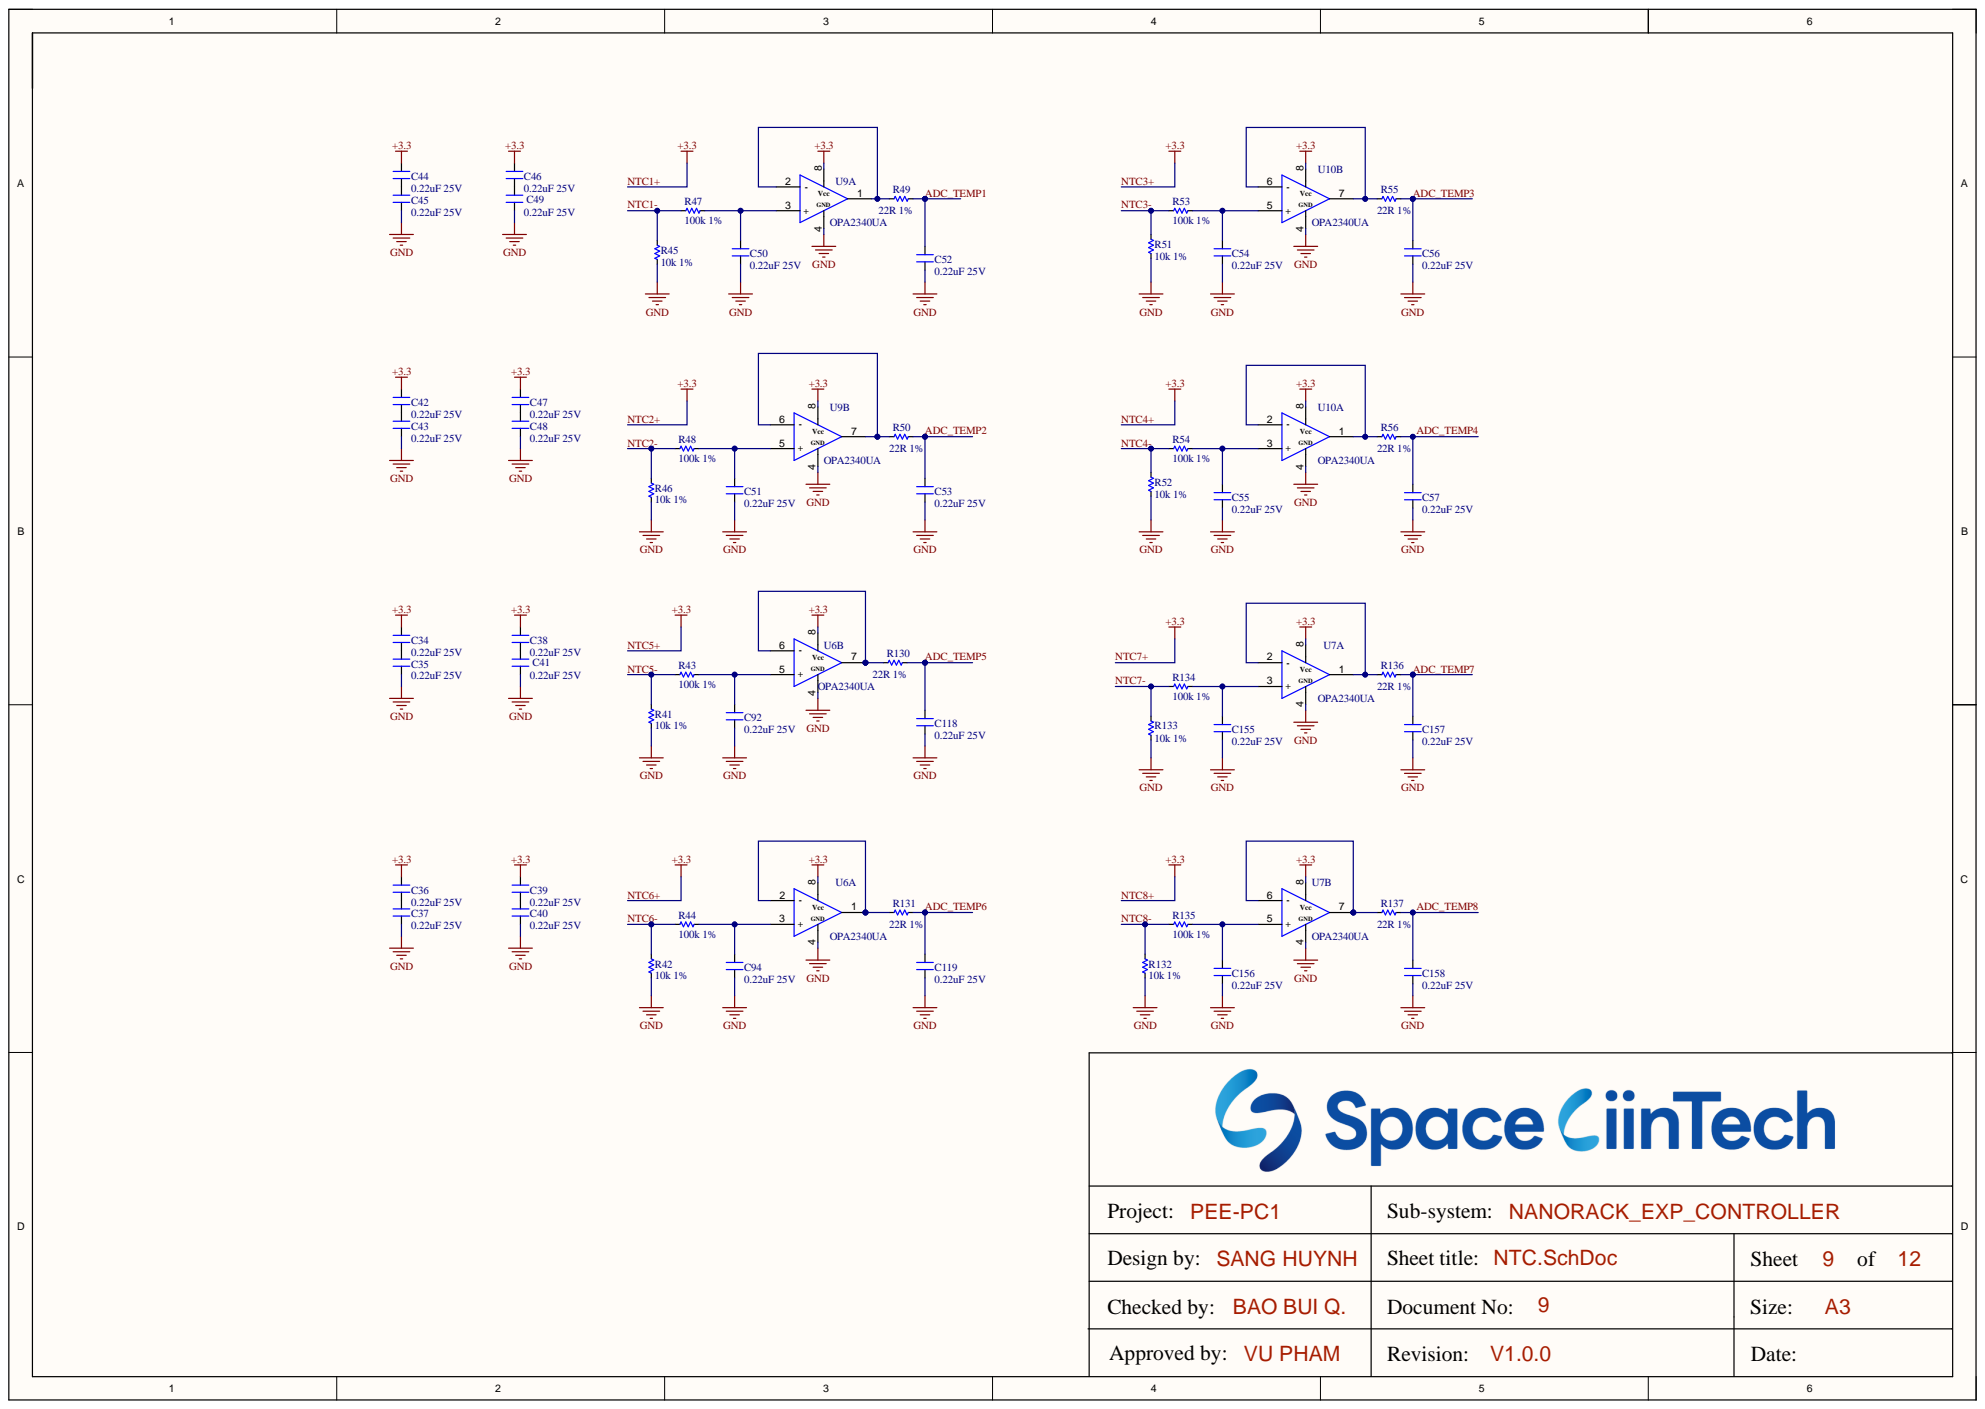
[picture p9: page 9]

Project: PEE-PC1 | Sub-system: NANORACK_EXP_CONTROLLER

Design by: SANG HUYNH | Sheet title: NTC.SchDoc | Sheet 9 of 12

Checked by: BAO BUI Q. | Document No: 9 | Size: A3

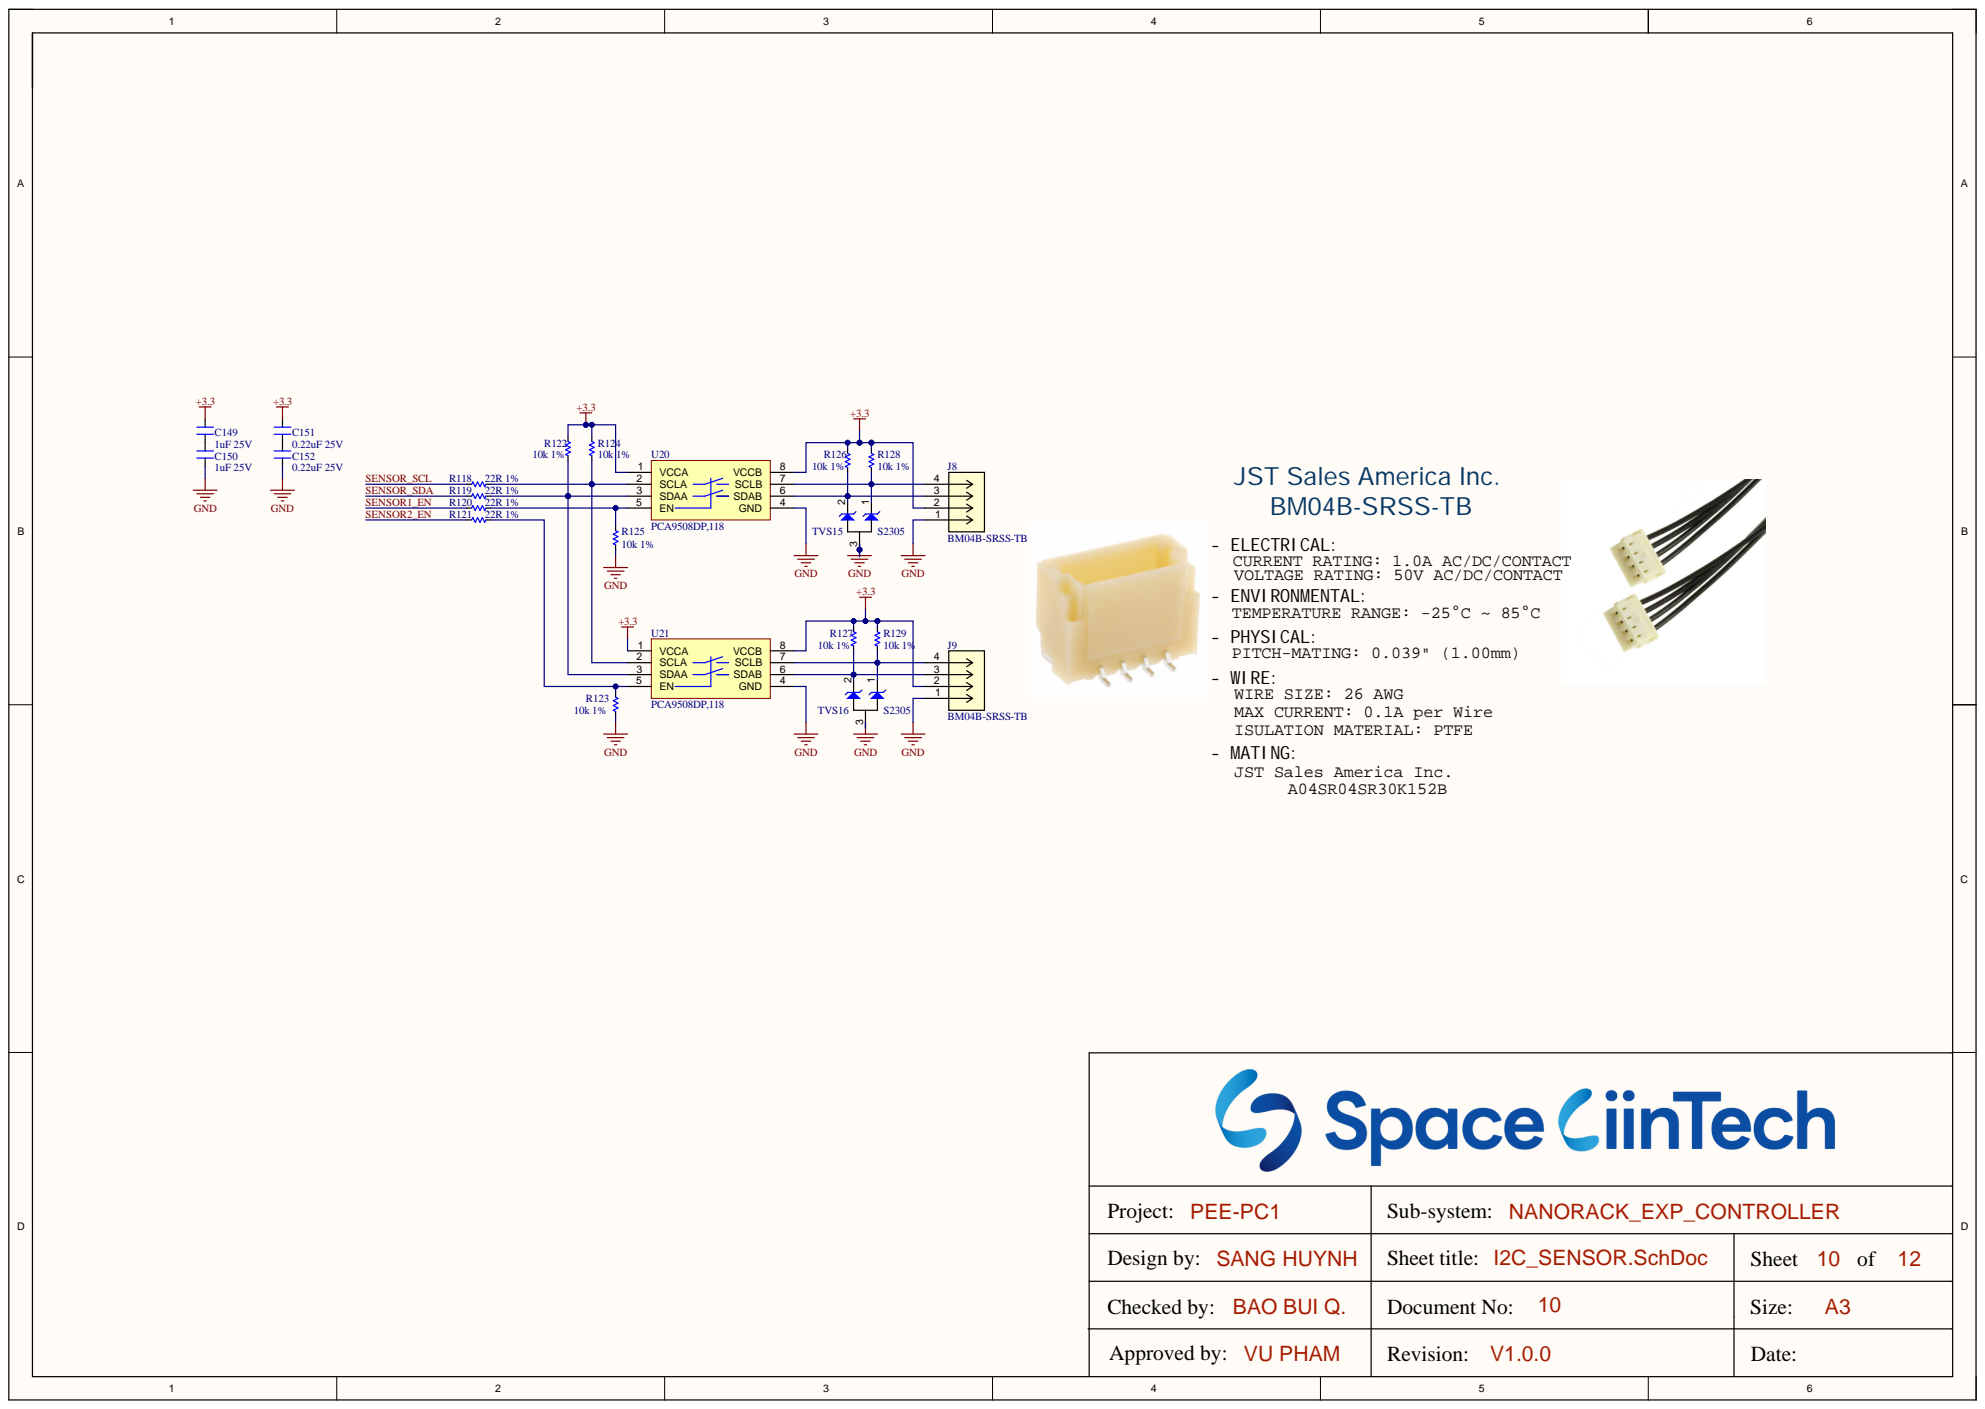
[picture p10: page 10]

Project : PEE-PC1 | Sub-system : NANORACK_EXP_CONTROLLER

Design by: SANG HUYNH | Sheet title: I2C_SENSOR.SchDoc | Sheet 10 of 12

Checked by: BAO BUI Q. | Document No: 10 | Size: A3

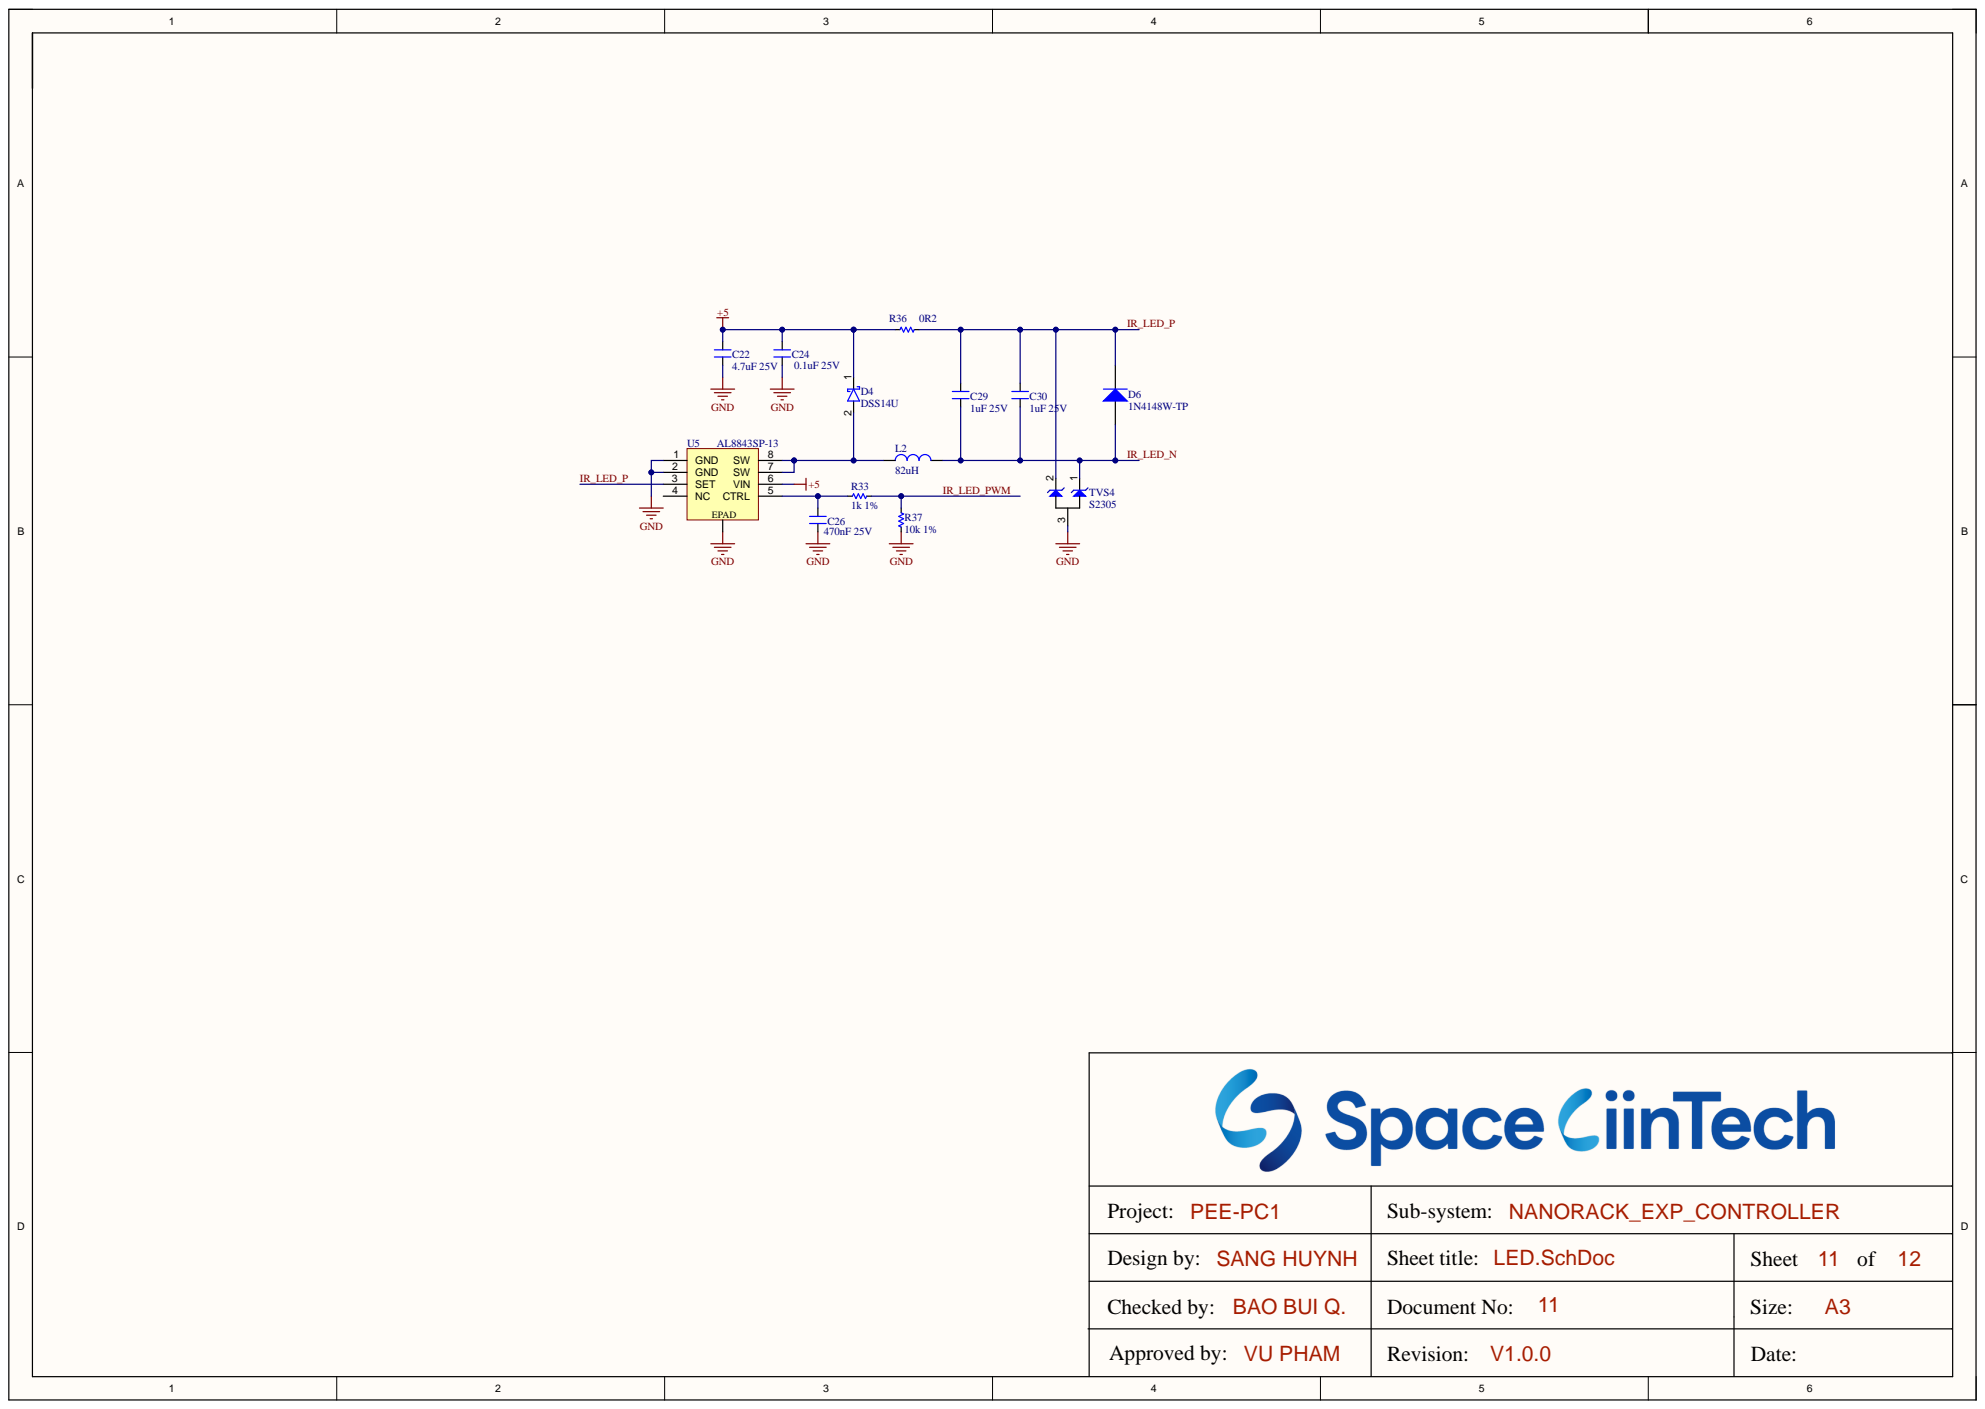
[picture p11: page 11]

Project : PEE-PC1 | Sub-system : NANORACK_EXP_CONTROLLER

Design by: SANG HUYNH | Sheet title: LED.SchDoc | Sheet 1 1 of 12

Checked by: BAO BUI Q. | Document No: V1.0.011 | Size: A3

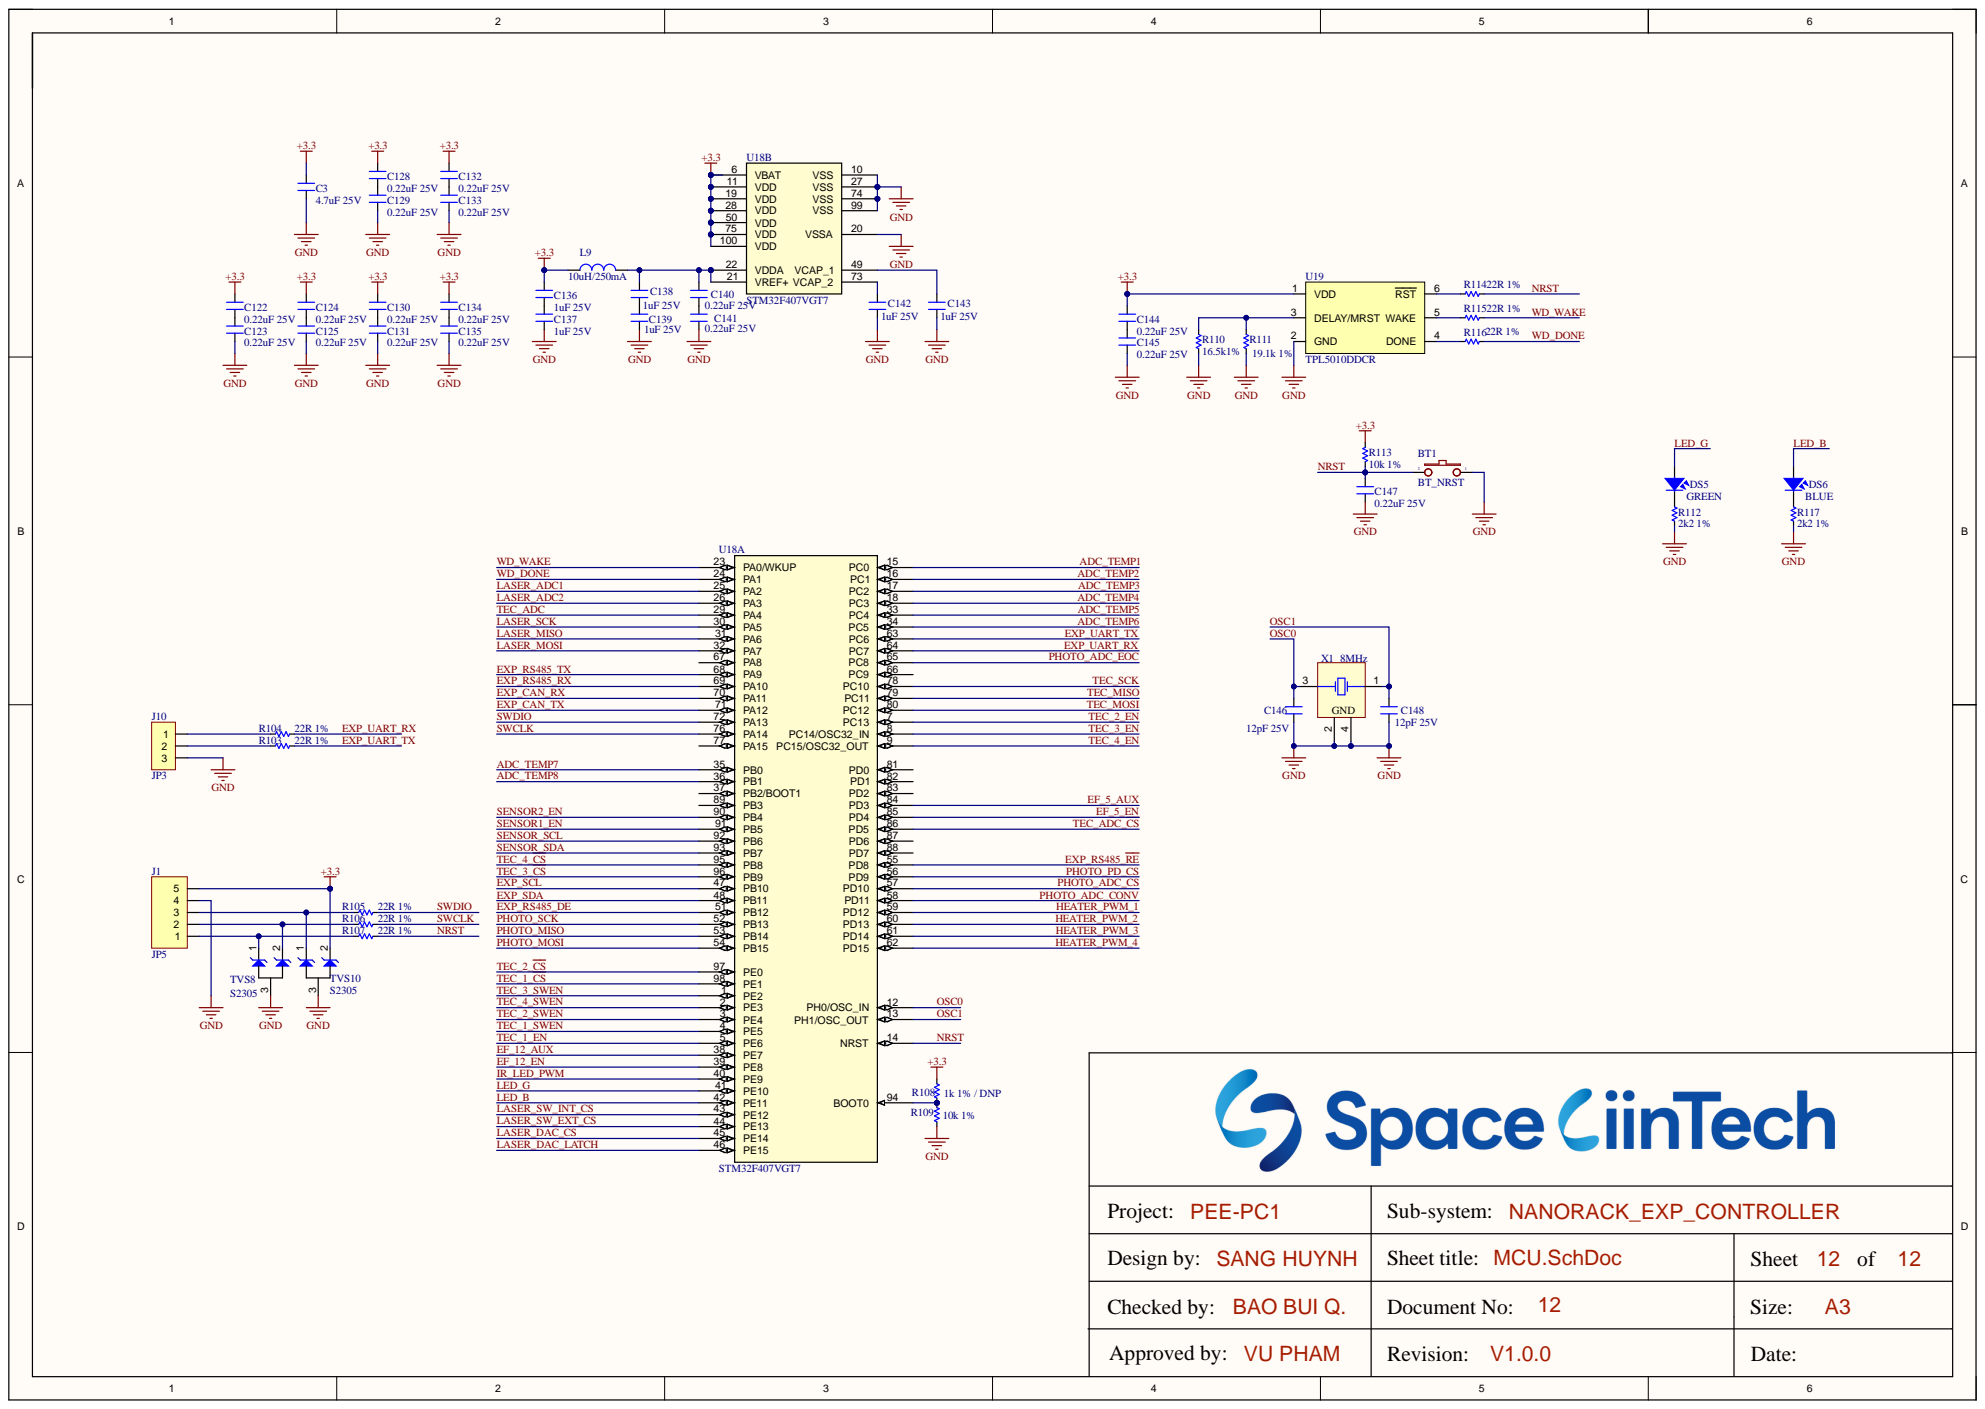
[picture p12: page 12]

1 1 | 2 7
1 9 | 7 4 | GN
2 8 | 9 9
5 0 | | 2 0

Project : PEE-PC1 | Sub-system : NANORACK_EXP_CONTROLLER

Design by: SANG HUYNH | Sheet title: MCU.SchDoc | Sheet 12 of 12

Checked by: BAO BUI Q. | Document No: 12 | Size: A3
