baobuibk/NANORACK_EXP_V101_HW/(list of files, drawings)

Other design files:
BLOCK_DIAGRAM.SchDoc
EXP_V100.PrjPcb
HEADERS_1.SchDoc
HEADERS_2.SchDoc
HEATER.SchDoc
I2C_SENSOR.SchDoc
INDEX.SchDoc
ISO_COM.SchDoc
LED.SchDoc
MCU.SchDoc
NTC.SchDoc
POWERchDoc.SchDoc
TECS_DRIVER.SchDoc
