baobuibk/NANORACK_EXP_V101_HW/(commit log)

2025-01-12 EXP_V101 | 120125
    [BLOCK_DIAGRAM.SchDoc, EXP_V100.PrjPcb, EXP_V100.xls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]
2025-01-13 EXP_V101 | 13012025
    [HEADERS_1.SchDoc, LED.SchDoc, MCU.SchDoc, TECS_DRIVER.SchDoc]
2025-01-17 EXP_V101 | 17012025
    [EXP_V100.PrjPcb, EXP_V100.xls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]
2025-01-18 EXP_V101 | 18012025
    [EXP_V100.PrjPcb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]
2025-01-19 EXP_V101 | 19012025
    [EXP_V100.PrjPcb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]
